worgarside/CubeSolver/Dissertation/Title.tex

\begin{titlepage}
	{\setstretch{1.5}
		
	    \centering
	   	\topskip0pt
	   	\vspace*{\fill}
	   	
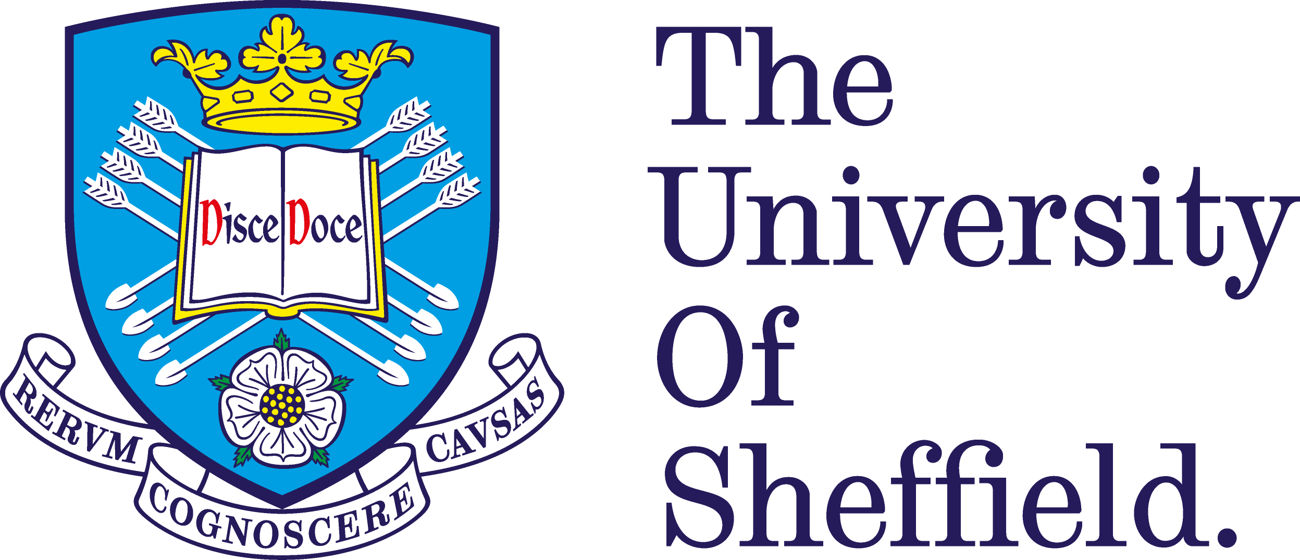
[picture p1: Dissertation/Resources/Images/imgTUoSLogo.png]
		 \\
	   	\vspace{1.5cm}
	    {\Huge Analysis of Rubik's Cube Solution Algorithms with a LEGO Mindstorms Robot} 
	    
		\vspace{1.5cm}
	    
	    {\huge Will Garside}
	    \vspace{2cm}
	    
	    {\Large Supervisor: Dr. Siobh\'{a}n North} \\
	    {\Large Department of Computer Science} \\
	    {\Large COM3610} \\
	    {\Large 2nd May 2018} 
	    
	    \vspace{0.8cm}
	    
		{\Large This report is submitted in partial fulfilment of the requirement for the degree of BSc Computer Science} \\
		{\Large \tit{by}} \\
		{\Large William O. R. Garside} \\
	
	    \vspace*{\fill}
	}
\end{titlepage}
