worgarside/CubeSolver/Dissertation/Research/Thistlethwaite letter.docx

26 Queens Road,

Loughton,

Essex.

13 July 1981.

Dear

Thank you for your letter asking for a copy of my

52-move strategy for solving Rubik's Cube. Please find

enclosed the following:-

(i) General instructions and description (3 pages);

(ii) Tables for Stage 2 (computer print-out);

(iii) Instructions and table for the first part of Stage 3;

(iv) Tables for the latter part of stage 3 (7 typewritten pages);

(v) Tables for Stage 4 (7 pages of computer print-out, photocopied).

I should perhaps point out that this strategy isn't

easy to perform (even John Conway finds it quite hard!),

for two reasons: first, only one representative of each

symmetry class is given in the tables; second, I have

given only the barest documentation. I hope that a fuller

description will be forthcoming at some stage.

On reading the bottom of page 2 of the General Instructions,

you will note that in fact Stage 2 requires two sets of

tables. I have omitted to send you the second of these,

because they are bulky, and only save one move! I hope you

will excuse this liberty. One can always get FU,FD,BU,BD

into the UD-slice (the middle horizontal slice) in at

most five moves in G1.

As an example of the strategy at work, consider the

position where the four upper corners are twisted clockwise,

the four lower corners are twisted antlclockwise, and all

twelve edges are flipped. Then the cube is restored by:-

Stage 1 DBFUR'L'D

Stage 2 L²F²D²F | L²R²F'R'BR²B'R'B'

Stage 3 L²B² | U²LU²F²L²F²L'B²LB²L'

Stage 4 R²U² | R²D²F²U²B²D²F²B²L²B²L²B²

Yours sincerely,

Morwen B. Thistlethwaite.

THE 45-52 MOVE STRATEGY

Introduction. Let G= <L,R,F,B,U,D> , G1= <L,R,F,B,U²,D²> ,

G2= <L,R,F²,B²,U²,D²> , G3= <L2,R2,F2,B2,U²,D²> . The plan is to

manoeuvre down through the chain G=G0> G1> G2> G3> 1. One gets from

Gi to Gi+1 by using moves in Gi only. In its shortest form this

strategy would be executed with the help of a computer, in which case

I conjecture only 45 moves would be needed, but here I have sacrificed

7 moves in order that there should be no need for a computer. With a

few more pages of tables, the figure 52 could be reduced to an

intermediate figure of, say, 49. I intend to do this shortly!

The indexes of the chain of subgroups are 2048, 1082565, 29400, 663552,

but these figures are considerably reduced by considering symmetries.

The reader may check that these indexes multiply together to give the

order of G. The accompanying tables are broadly classified according to

corner positions, and in detail according to edge positions. The words

listed actually produce the positions under consideration, so the

restoring moves are the inverses of these. In order to be able to use

the tables it is necessary to understand the basic characteristics of the

groups G1, G2, G3, so the necessary facts are presented below.

Getting into G1. This involves edge pieces only, and is easy, for which

reason no tables are given. An edge piece is BAD if in taking it home an odd

number of quarter-turns of U and D faces is needed; otherwise it is GOOD

(note that badness is well-defined). The reader may quickly work out a rule of

thumb for deciding whether a piece is GOOD or BAD. Now quarter-turns of

either U or D faces convert BAD pieces to GOOD and vice versa; other moves

have no effect. Therefore to make all edge pieces GOOD, move groups of them

to U or D face avoiding quarter-turns of U or D, and then cure them by

performing a quarter-turn of U or D. For example, if all twelve are BAD,

DBFUR'L'D will cure them all!

Getting from G1 into G2. What has been achieved so far (although

it doesn't look like it) is the correct orientation of edge pieces! In

the present stage, the same is accomplished for corners, and also the

edge pieces FU, FD, BU, BD are brought into their slice. As is well

known, corners do not in general have a natural orientation, but here,

roughly speaking, we shall line them all up the same way. More precisely,

note that each corner piece has either a L-facet or a R-facet: on

completion of this stage each of these facets will lie on either the L

or the R face. In fact, the same will be true of the eight edge pieces

with L or R facets, in view of the statement above regarding FU, FD, BU, BD.

There are 1082565 cases to consider here, this number being the product of

3^7(total number of corner orientations) , and 12C4 (total number of

arrangements of the set {FU, FD, BU, BD} amongst the twelve edge positions).

Surprisingly, with a certain amount of practice it is possible to get

through this stage in at most 17 moves without tables; the same is most

certainly not true of the next stage although there are only 29400 cases.

However, with a few pages of tables this figure of 17 may be reduced to 13;

with a great deal more computation, it should be possible to reduce it

further to 10. To "prove" that 10 moves were sufficient, one would run

through all 10-move sequences on the computer, and check that 1082565 different

cases resulted. This would take no more than a few hours of computer

time, in view of certain short cuts available by considering symmetries.

Now to business. The twist of a corner is measured by looking at its

L or R facet and observing how this has been rotated in relation to the

adjacent L or R face. Note that quarter-turns of F and B faces alter the

twist of corners, whereas all other moves in the group G1 have no effect.

Now in at most 4 moves in G1 try to obtain a position where ~~either the corners~~

~~on the F face or the corners on the B face have zero twist. Note the twist~~

~~of the corners on the opposite face and also the~~ ~~positiosn~~ ~~of the edge pieces~~

the edge pieces FU, FD, BU, BD are all in the UD-slice. If this is not

possible, get them all in the U-face in at most 4 moves.

~~FU, FB, BU, BD, and~~ ~~t~~Then refer to the appropriate detailed table. The

words listed in these tables need to be inverted, as mentioned earlier.

Getting from G2 into G3. This is the trickiest stage theoretically,

and may be broken down for purposes of clarification into two sub-stages:

first get corners into their natural orbits, and second permute the

corners within their orbits so as to obtain one of the 96 corner permutations

in the squares group (G3), while at the same time sorting out the edge

pieces into their correct slices. The table of initial moves on the first

page of Stage 3 tables does part of the first of these substages, and the

detailed tables do the rest. After performing the initial moves, the set

of corners out of orbit will be one of three possibilities (modulo symmetries):

(i) the empty set; (ii) the set {1, 8, 2, 7} ; (iii) the set {1, 5} .

The reader then has to calculate which coset of form G3αβ the permutation

of corners lies in, where α is one of 1, (14)(68), (24)(58), (12), (14), (24),

and β is one of 1, (18)(27), (15). Since some of these cosets are reflections

of others, it was not necessary to produce tables for all six possible values

of α. The task of reflecting positions if necessary is left to the reader.

I apologise for the slightly anomalous numbering of edge positions for this

stage; this was due originally to a typing error in a programs and has

stuck ever since!

Getting from G3 to home. In this final stage one uses only 180 turns.

The order of G3 is 96x6912 = 663552. The tables for this stage give words

for producing each of the 6912 edge positions with corners fixed. Therefore

one must first restore the corners (in at most 4 moves), and then use the

tables to restore the edges. Considerable practice is needed to use these

tables efficiently, but I have found (after considerable practice) that I

can find the desired move in about 2 minutes. One hint is that when faced

with three 3-cycles, consider the configuration of the fixed pieces. Also

it pays to get to know the different sorts of 4-cycle.

STAGE 2 TABLES

FIRST BATCH OF NUMBERS: THE MOVES.

11=L 12=L² 13=L'

21=F 22=F² 23=F'

31=R 32=R² 33=R'

41=B 42=B² 43=B'

51=U² 52=D²

SECOND BATCH OF NUMBERS: TWISTS OF CORNERS.

1=CLOCKWISE 2=ANTICLOCKWISE 0=NO EFFECT

FINAL NUMBER: NUMBER OF SYMMETRICALLY EQUIVALENT POSITIONS.

N.B. FOR INITIAL 1X READ 21 1X.

21 11 31 22 11 31 51 52 21 0 0 0 0 0 0 0 0 1

21 11 33 42 11 51 33 52 21 0 0 0 1 0 0 2 0 4

21 11 22 51 52 12 22 33 21 0 0 0 1 1 0 2 2 8

21 11 22 31 43 51 13 22 11 0 0 0 1 1 1 2 1 8

21 11 52 11 21 31 52 41 51 0 0 0 1 2 2 0 1 8

21 11 22 12 52 12 52 31 41 0 0 0 2 0 1 2 1 8

11 21 33 23 11 32 51 52 23 0 0 1 0 0 0 2 0 4

11 21 33 23 11 32 51 52 21 0 0 1 0 2 0 0 0 4

11 42 31 21 13 42 33 41 51 0 0 1 1 0 0 2 2 2

21 11 21 33 42 11 23 12 43 0 0 1 1 0 1 0 0 8

21 11 22 31 41 11 32 42 13 0 0 1 1 1 0 1 2 8

21 11 31 21 51 31 21 41 11 0 0 1 1 2 2 0 0 2

21 11 22 32 41 51 13 22 11 0 0 1 1 2 2 2 1 8

21 11 21 41 11 23 41 11 43 0 0 1 2 0 0 0 0 8

21 11 41 51 41 12 42 11 41 0 0 1 2 0 0 1 2 4

21 11 42 12 41 52 41 11 41 0 0 1 2 0 0 2 1 4

21 11 21 32 42 11 23 12 43 0 0 1 2 0 1 0 2 8

21 11 22 12 22 51 31 52 21 0 0 1 2 1 0 0 2 8

21 11 21 12 23 42 11 43 12 0 0 1 2 1 0 1 1 8

21 11 22 13 21 31 21 11 41 0 0 1 2 1 1 0 1 8

21 11 21 41 11 23 43 11 43 0 0 1 2 2 1 0 0 4

21 11 22 11 52 33 51 21 51 0 0 2 0 0 0 0 1 4

21 11 22 11 22 52 33 51 23 0 0 2 0 0 0 1 0 4

21 11 22 11 52 33 51 21 12 0 0 2 0 0 1 0 0 4

21 11 22 11 22 52 33 51 21 0 0 2 0 1 0 0 0 4

21 11 33 42 11 21 12 31 43 0 0 2 1 1 0 0 2 8

21 11 22 13 21 13 21 12 43 0 0 2 1 1 1 2 2 8

21 11 21 11 52 11 23 11 43 0 0 2 2 0 0 1 1 2

21 11 22 11 32 52 33 51 23 0 0 2 2 0 0 2 0 8

21 11 23 11 33 51 21 12 43 0 0 2 2 2 0 0 0 8

21 11 51 31 23 52 12 21 33 0 1 0 0 0 2 1 2 8

21 11 22 51 52 12 22 33 23 0 1 0 0 2 0 1 2 8

21 11 52 11 21 31 52 41 12 0 1 0 0 2 1 0 2 8

21 11 32 43 12 31 43 51 31 0 1 0 0 2 2 2 2 8

21 11 21 43 11 31 21 51 31 0 1 0 1 2 0 1 1 8

21 12 22 51 52 31 22 32 21 0 1 0 1 2 0 2 0 2

11 23 41 31 41 11 33 52 21 0 1 0 1 2 2 0 0 8

21 11 22 12 51 31 52 21 12 0 1 0 2 0 0 1 2 8

21 11 32 51 43 52 33 23 12 0 1 0 2 0 2 0 1 4

11 22 11 51 41 11 52 23 51 0 1 0 2 1 0 2 0 4

21 11 42 51 41 11 33 23 33 0 1 0 2 2 1 2 1 8

21 11 51 33 41 33 21 51 11 0 1 0 2 2 2 0 2 8

11 22 51 43 11 33 21 42 11 0 1 1 0 0 2 0 2 8

12 22 51 52 31 22 32 21 31 0 1 1 0 2 0 0 2 2

21 11 21 43 11 31 21 51 33 0 1 1 0 2 0 1 1 8

21 11 22 31 41 13 22 13 22 0 1 1 0 2 1 0 1 8

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

21 11 21 11 22 33 21 12 41 2 2 2 2 0 2 1 1 8

21 11 21 13 23 31 21 33 43 2 2 2 2 0 2 2 0 4

21 11 21 31 42 33 23 13 41 2 2 2 2 1 1 1 1 1

21 11 22 32 51 11 52 33 21 2 2 2 2 2 0 2 0 4

21 11 21 31 21 33 22 13 41 2 2 2 2 2 2 1 2 8

STAGE 3: GETTING INTO THE SQUARES GROUP

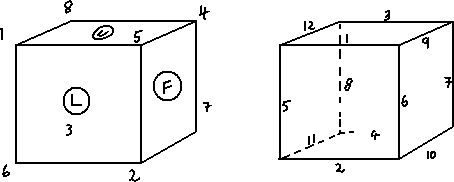
[picture p55: figure]

Corners and edges are numbered as in the above diagrams.

Moves are coded as follows:

1=L, 2=L², 3=L', 4=F², 5=R, 6=R², 7=R', 8=B², 9=U², 10=D².

To accomplish stage 3, proceed as follows:

(i) Establish which corners are out of orbit.

(ii) Perform moves as indicated in the table below.

(iii) Find by calculation the right coset of the squares group

in which the permutation of corners now lies.

(iv) Refer to the appropriate detailed table. Find the numbers

of the positions of the four edge pieces of the FB-slice,

i.e. LU, LD, RU, RD. Find the number in the left-hand

column corresponding to these, and perform the inverse of

the given move. since some cosets are reflections of

others, the reader may have to undertake the extra task

of reflecting his position to find a suitable table.

CORNERS OUT OF ORBIT | INITIAL MOVE

1,5 | -

1,6 | -

1,7 | 4

1,8 | 2 9

1,2,5,6 | 1

1,2,5,7 | 1 4

1,2,5,8 | 3 9

1,2,7,8 | -

1,3,6,8 | 9

1,3,5,7 | 6 4

1,3,5,8 | 1 9

1,2,3.5,6,7 | 1

1,2,3,5,7,8 | 4 5

1,2,3,6,7,8 | 1 5 9

1,2,3,4,5,6,7,8 | 1 5

CORNERS OUT OF ORBIT: NONE COSET: G COSET: G(14)(68)

1234 - 1 4 1 4 1 5 8 1 8 7

1235 1 4 1 7 4 10 2 7 1 4 1 4 9 2 9 7 4 7

1236 1 4 1 7 4 10 7 8 1 4 1 4 2 9 1 8 10 7

1237 1 4 1 7 4 10 7 4 1 4 1 4 2 8 9 7 9 7

1238 1 4 1 7 4 9 3 10 1 4 3 4 2 8 10 1 8 3

1245 1 4 1 7 4 10 2 5 1 4 1 4 2 9 1 4 10 7

1246 1 4 1 7 4 10 5 8 1 4 1 4 9 2 9 3 9 3

1247 1 4 1 7 4 10 5 4 1 4 3 4 1 5 8 3 8 10 3

1248 1 4 1 7 4 9 1 9 1 4 1 4 2 8 9 3 8 3

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

Now taking the corner positions in order (as in the

diagram in Stage 3 instructions), the respective twists of

the pieces in these positions are 0,2,0,2,0,0,1,1. This

combination of twists is not given in Stage 2 tables, but

a 180° rotation about the LR-axis followed by reflection

in the LR-slice transforms this to 2 2 0 0 0 1 0 1, which

is in the tables. The move given is F LFL2F'LF²BL², and

transforming this by the above (involutory) symmetry gives

B'R'B'R²BR'B²F'R². Therefore we perform the inverse of

this move, after which L and R faces have L and R colours

on them only.

Summary of Stage 2:- F²D²LR'FR²FB²RB'R²BRB (14 moves)

Stage 3. The positions where corners are out of orbit are

numbers 1,2,5,8. The preliminary instructions for this

stage instruct us to perform L'U². For the remainder of

this stage alter the coordinate system so that the original

D-face faces you and the original F-face faces upwards.

In this new coordinate system the positions where corners

are out of orbit are 1,5. The permutation of corners is

(1357)(24). Multiplying this on the right by (15)(24) gives

(13)(57) which is a permutation of corners in G3. Therefore

we must refer to page 7 of the Stage 3 tables. The edge-

pieces of the FB-slice are in positions 3,4,5,8. The tables

give us LF²L'U²LF²R²F²B²R, or LD²L'F²LD²R²D²U²R in the

original coordinate system. Perform the inverse of this move.

Summary of Stage 3:- L'U²R'U²D²R²D²L'F²LD²L' (12 moves).

Stage 4. The corners are restored by L²R²(original coordinates).

Looking at edge-pieces, as no slice is fixed and there is

a 2-cycle and a 4-cycle, we refer to page 7 of the Stage 4

tables. The only entries where the correct arrangement of

pieces is permuted and the 4-cycle is of the correct type are

(143) (1342) (34) and (143) (1243) (34). If we hold the

Cube with the original R-face facing the operator, and the

original B-face uppermost, we find we have the second of these

permutations. Therefore perform the inverse of the move

given, i.e. perform B²R²F²R²D²U²B²U²R²U²R²U²in original coords.

Summary of Stage 4:- L²R²B²R²F²R²D²U²B²U²R²U²R²U²(14 moves).

Total number of moves required: 6+14+12+14 = 46. (45 with cancellation)

M.B.T.
