worgarside/CubeSolver/Dissertation/Research/rvgrol@hotmail.com/IMG_0400.JPG.JPG

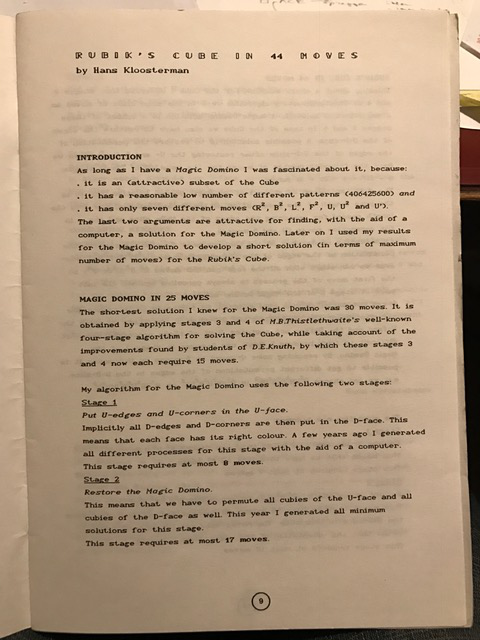
Dissertation/Research/rvgrol@hotmail.com/IMG_0400.JPG.JPG
