worgarside/CubeSolver/Dissertation/Research/rvgrol@hotmail.com/IMG_0401.JPG.JPG

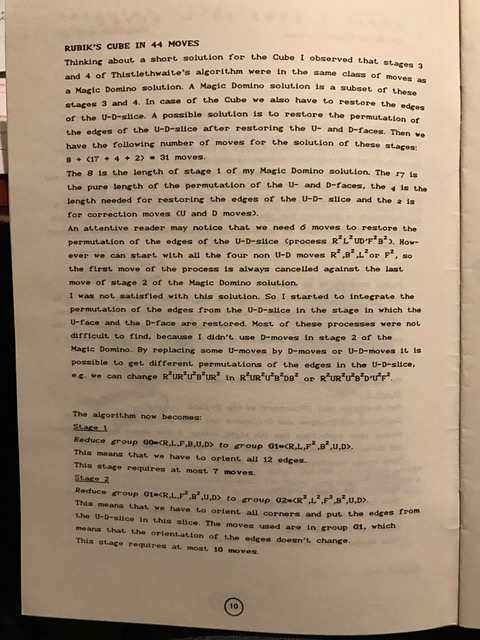
Dissertation/Research/rvgrol@hotmail.com/IMG_0401.JPG.JPG
