worgarside/CubeSolver/Dissertation/Research/rvgrol@hotmail.com/IMG_0402.JPG.JPG

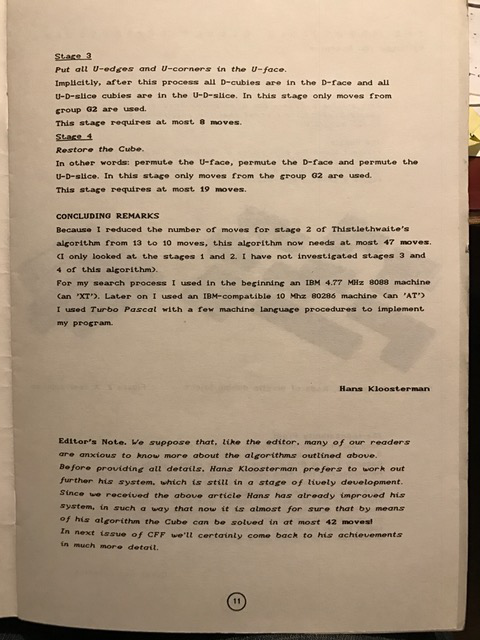
Dissertation/Research/rvgrol@hotmail.com/IMG_0402.JPG.JPG
