worgarside/CubeSolver/Dissertation/Resources/Images/dwgCubeProfile.PNG

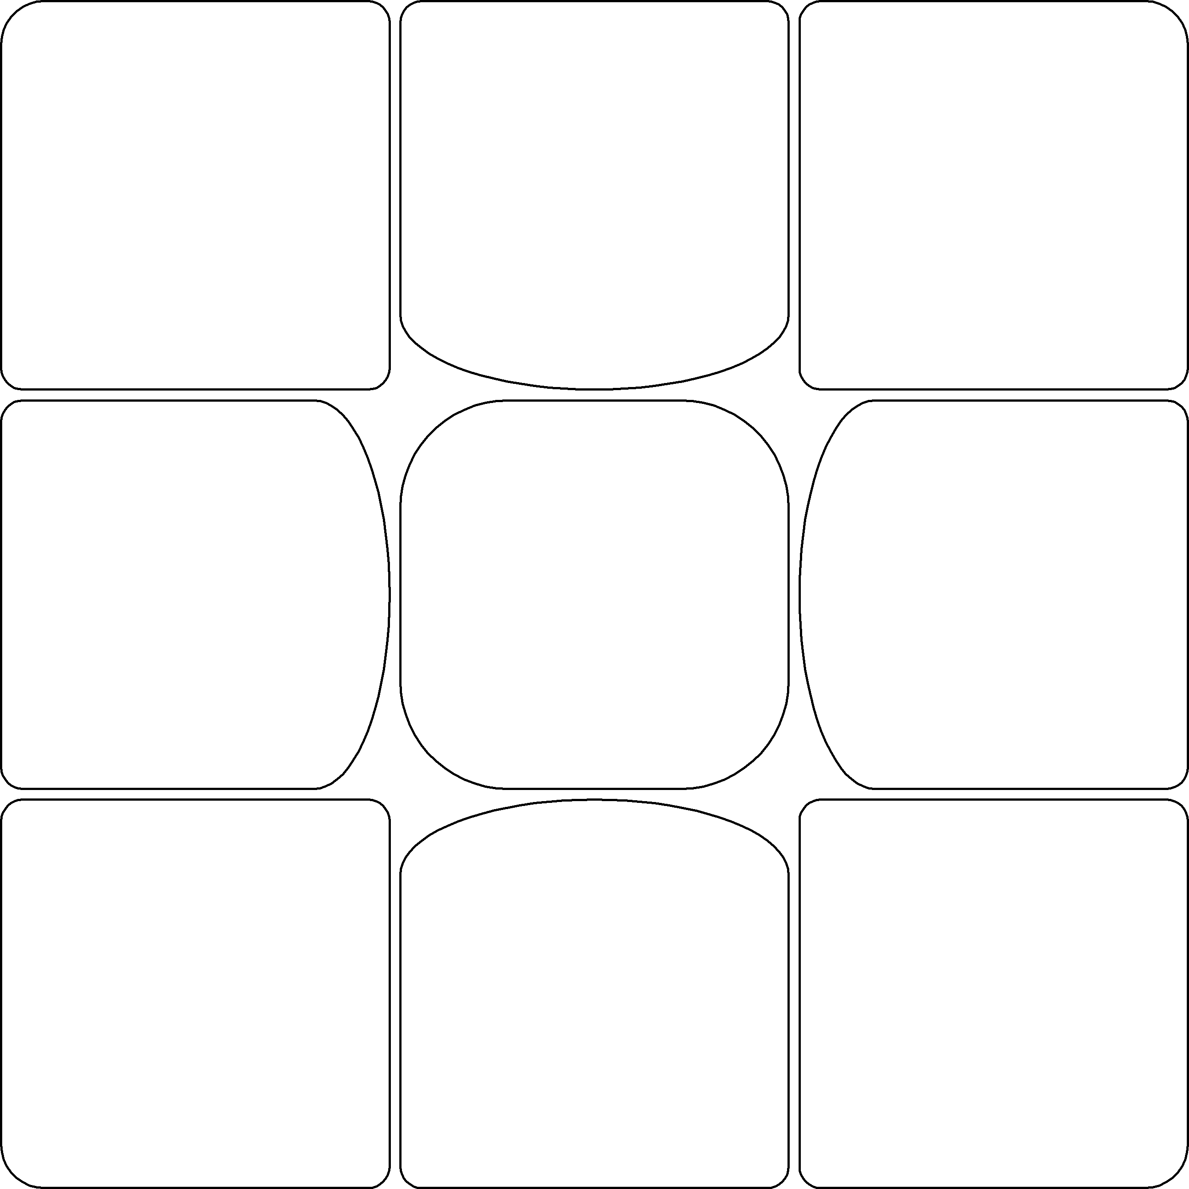
Dissertation/Resources/Images/dwgCubeProfile.PNG
