worgarside/CubeSolver/Dissertation/Resources/Images/imgBatteryHolder.jpg

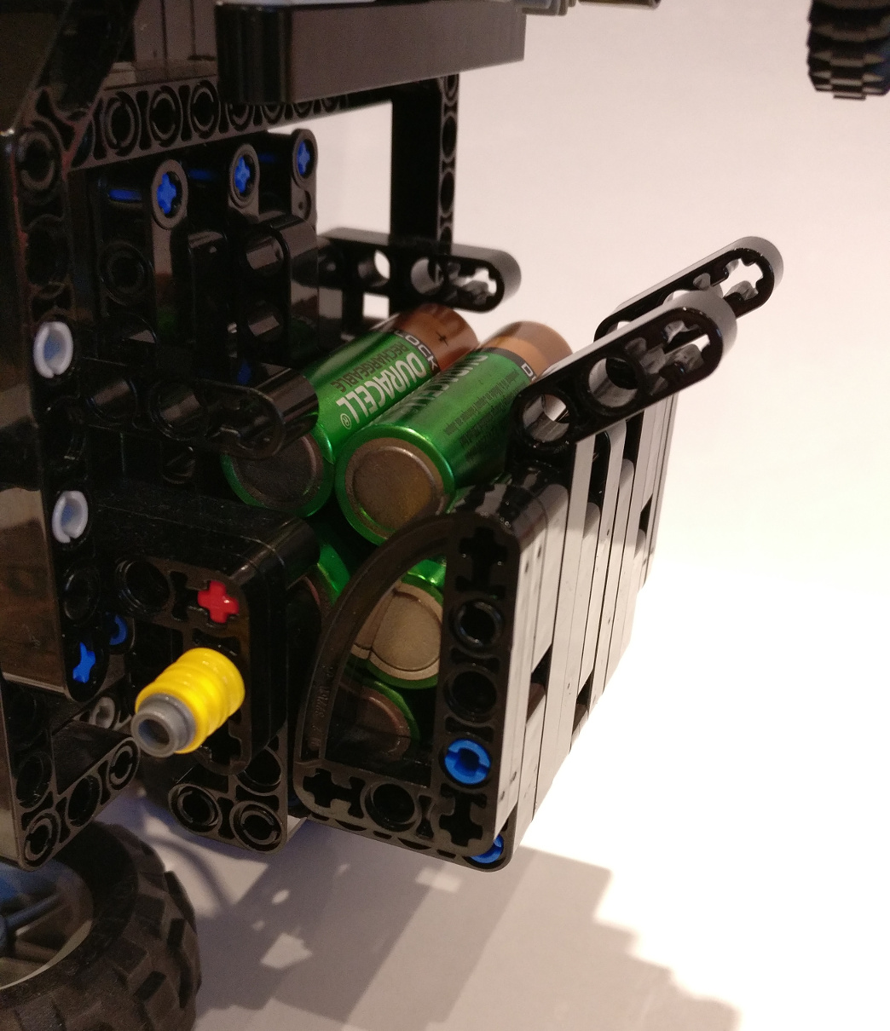
Dissertation/Resources/Images/imgBatteryHolder.jpg
