worgarside/CubeSolver/Dissertation/Resources/Images/imgBatteryHolderOpen.jpg

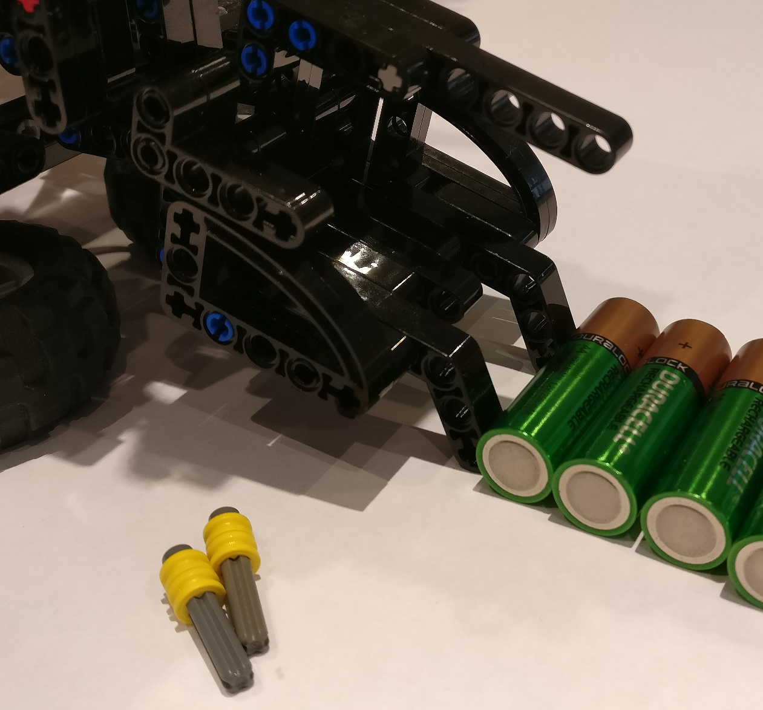
Dissertation/Resources/Images/imgBatteryHolderOpen.jpg
