worgarside/CubeSolver/Dissertation/Resources/Images/rdrBatteryHolder.png

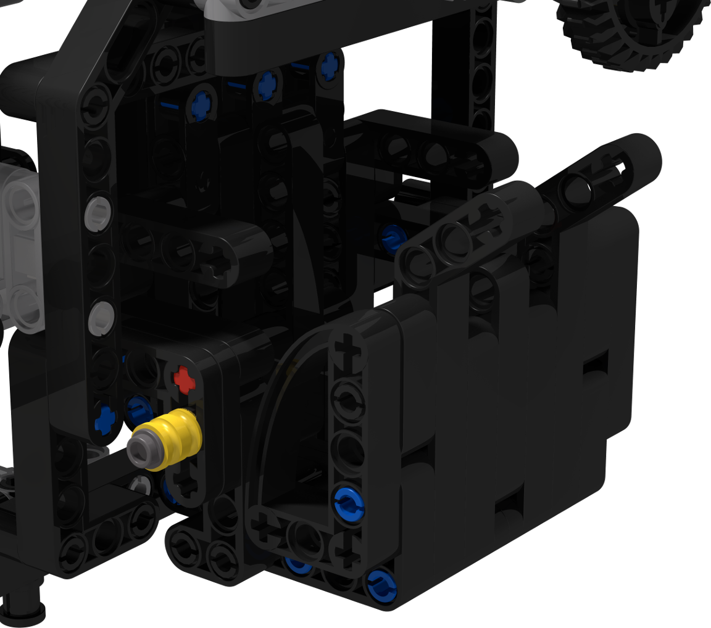
Dissertation/Resources/Images/rdrBatteryHolder.png
