worgarside/CubeSolver/Dissertation/Resources/Images/rdrFullRobotV1Rear.png

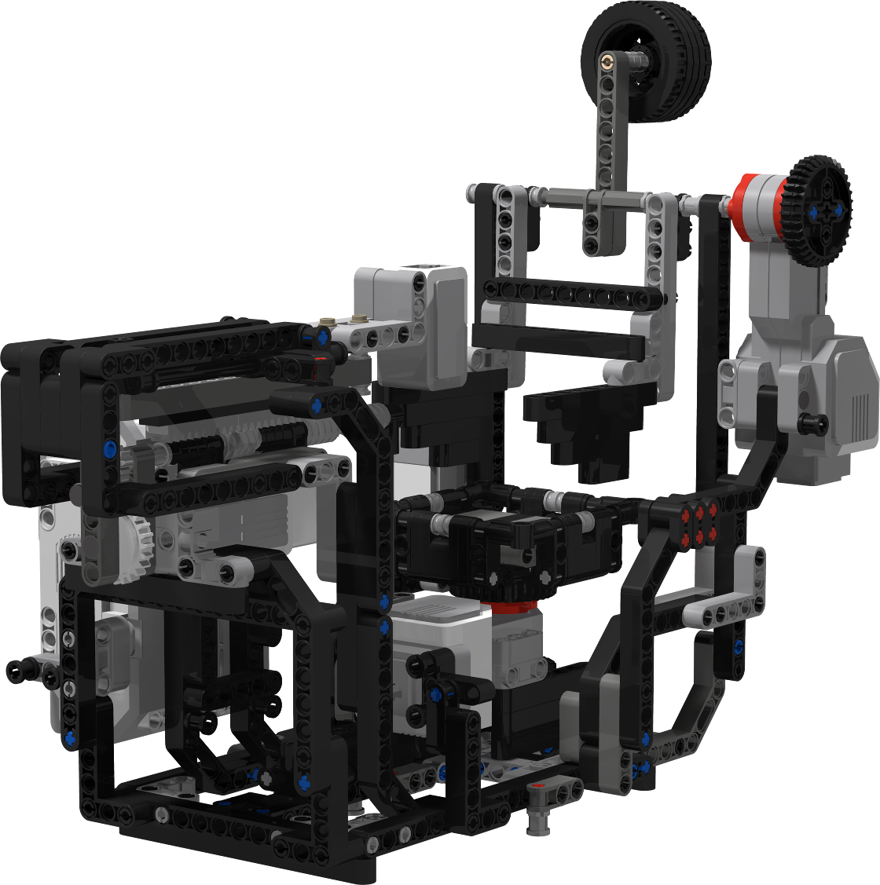
Dissertation/Resources/Images/rdrFullRobotV1Rear.png
