worgarside/CubeSolver/Dissertation/Resources/Images/rdrLego60c01.png

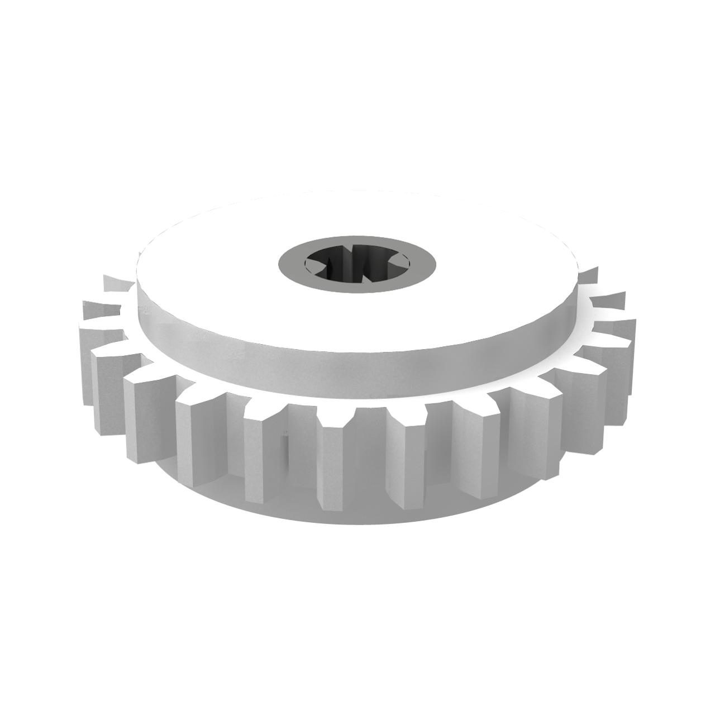
Dissertation/Resources/Images/rdrLego60c01.png
