worgarside/CubeSolver/Dissertation/Resources/Images/rdrLego3647.png

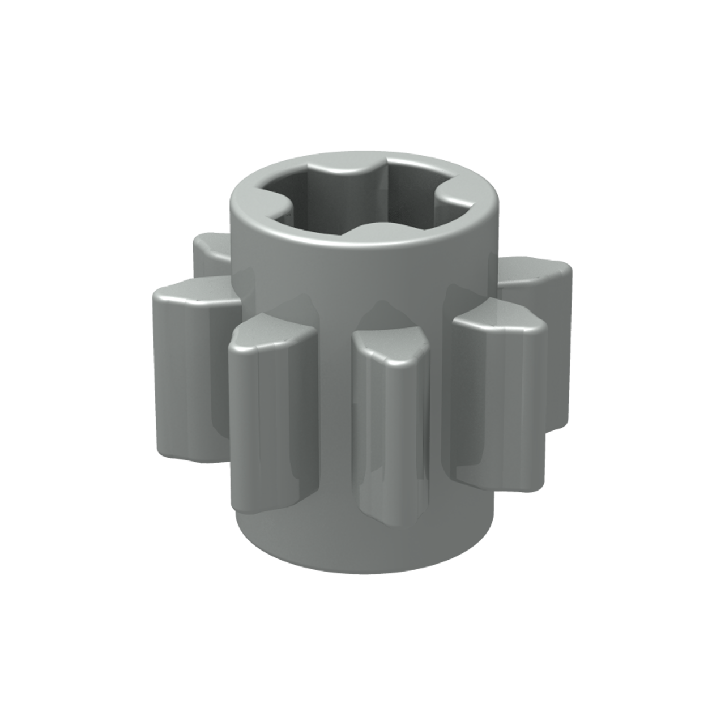
Dissertation/Resources/Images/rdrLego3647.png
