worgarside/CubeSolver/Dissertation/Resources/Images/rdrLego3649.png

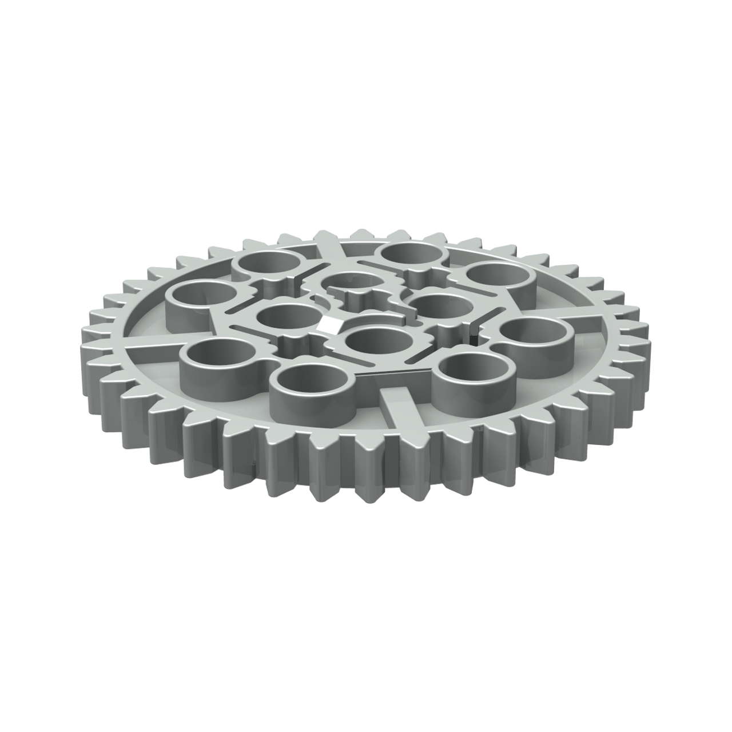
Dissertation/Resources/Images/rdrLego3649.png
