worgarside/CubeSolver/Dissertation/Resources/Images/rdrLego3708.png

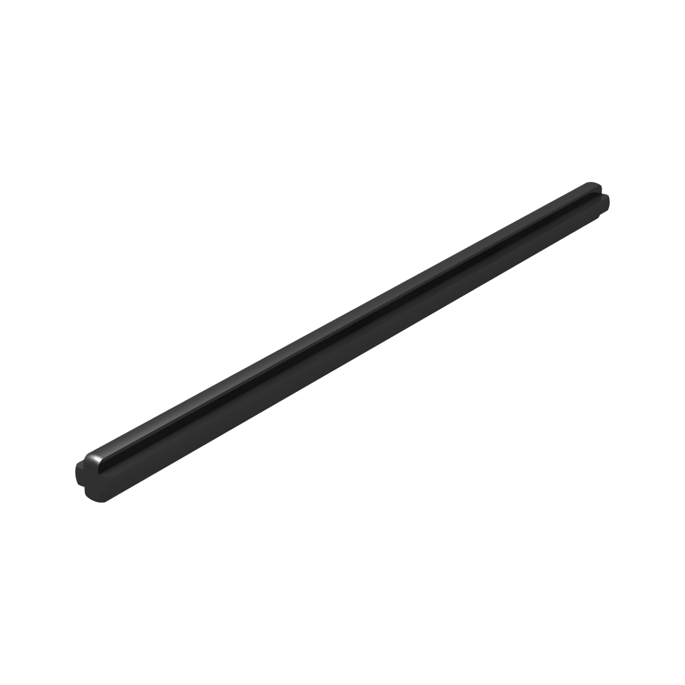
Dissertation/Resources/Images/rdrLego3708.png
