worgarside/CubeSolver/Dissertation/Resources/Images/rdrLego3743.png

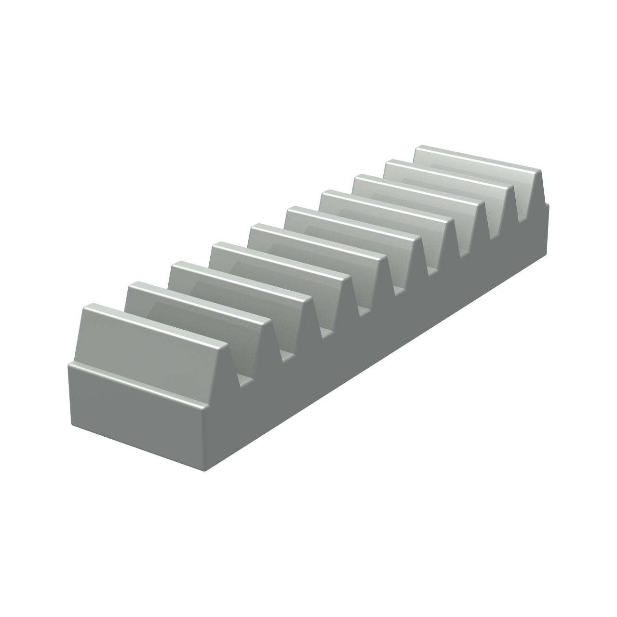
Dissertation/Resources/Images/rdrLego3743.png
