worgarside/CubeSolver/Dissertation/Resources/Images/rdrLego4716.png

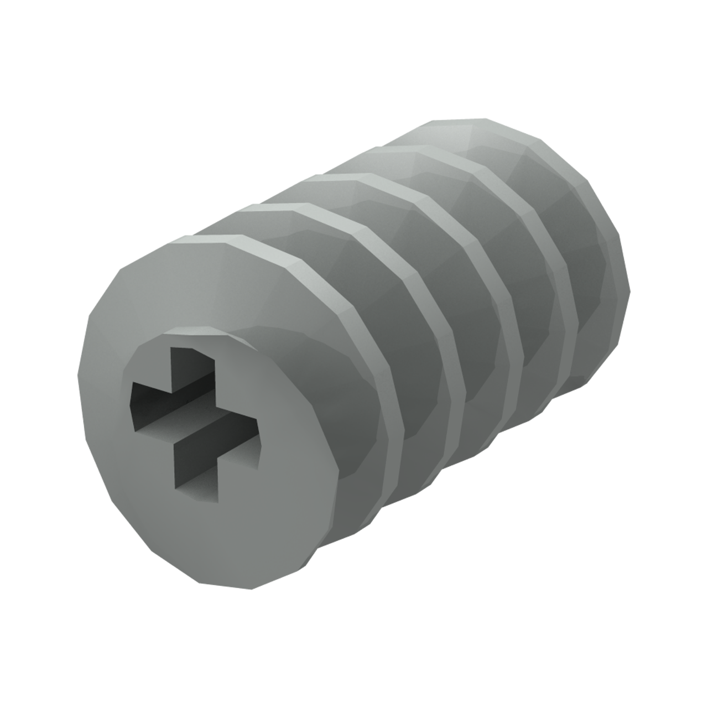
Dissertation/Resources/Images/rdrLego4716.png
