worgarside/CubeSolver/Dissertation/Resources/Images/rdrLego32009.png

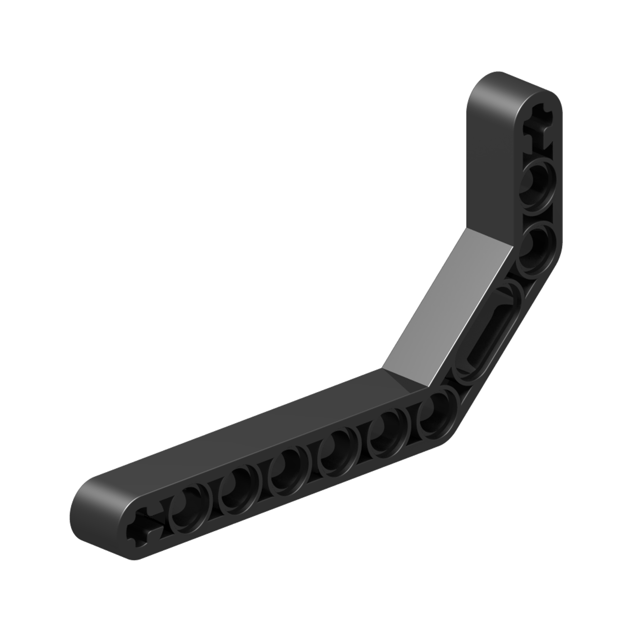
Dissertation/Resources/Images/rdrLego32009.png
