worgarside/CubeSolver/Dissertation/Resources/Images/rdrLego32054.png

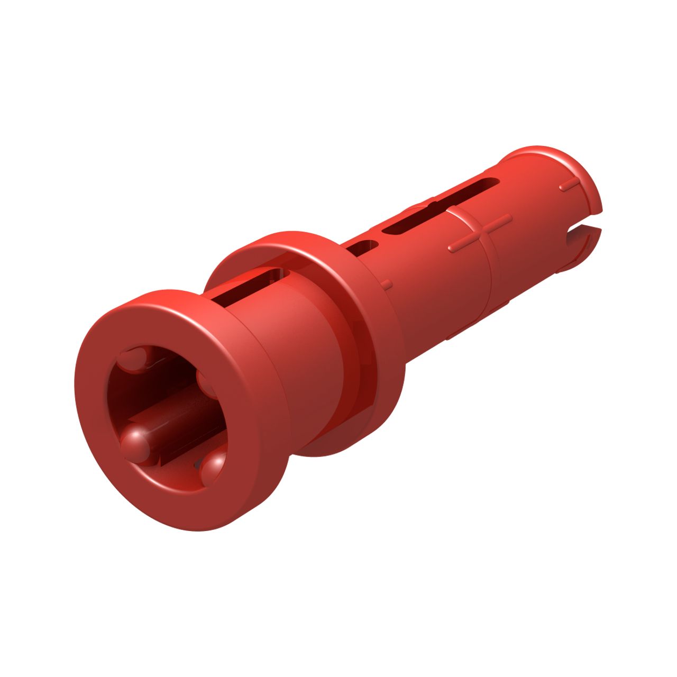
Dissertation/Resources/Images/rdrLego32054.png
