worgarside/CubeSolver/Dissertation/Resources/Images/rdrLego32062.png

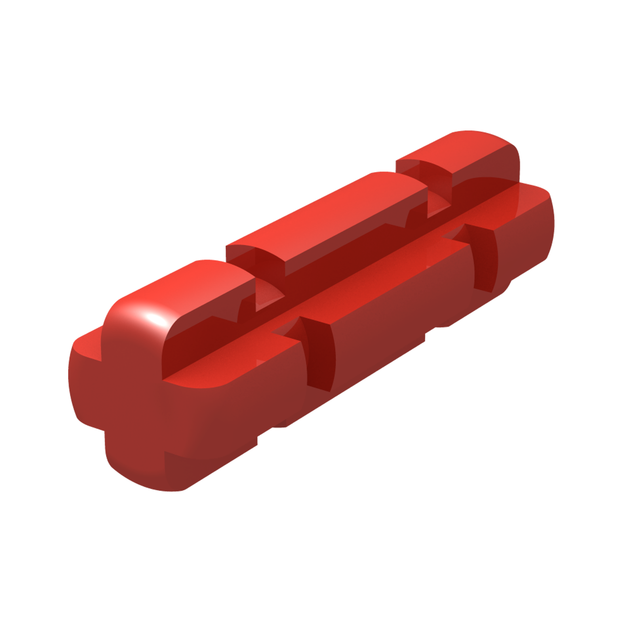
Dissertation/Resources/Images/rdrLego32062.png
