worgarside/CubeSolver/Dissertation/Resources/Images/rdrLego32270.png

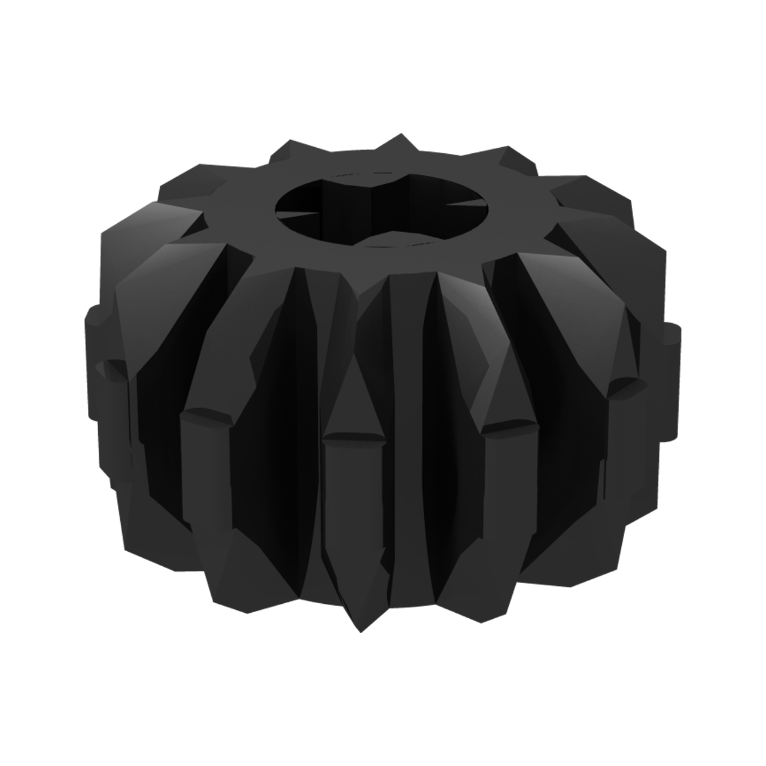
Dissertation/Resources/Images/rdrLego32270.png
