worgarside/CubeSolver/Dissertation/Resources/Images/rdrLego32498.png

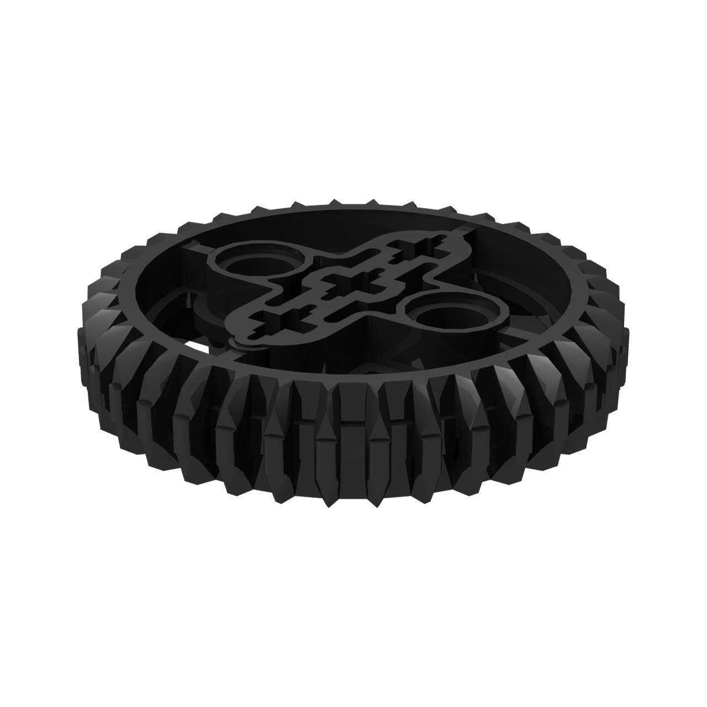
Dissertation/Resources/Images/rdrLego32498.png
