worgarside/CubeSolver/Dissertation/Resources/Images/rdrLego32526.png

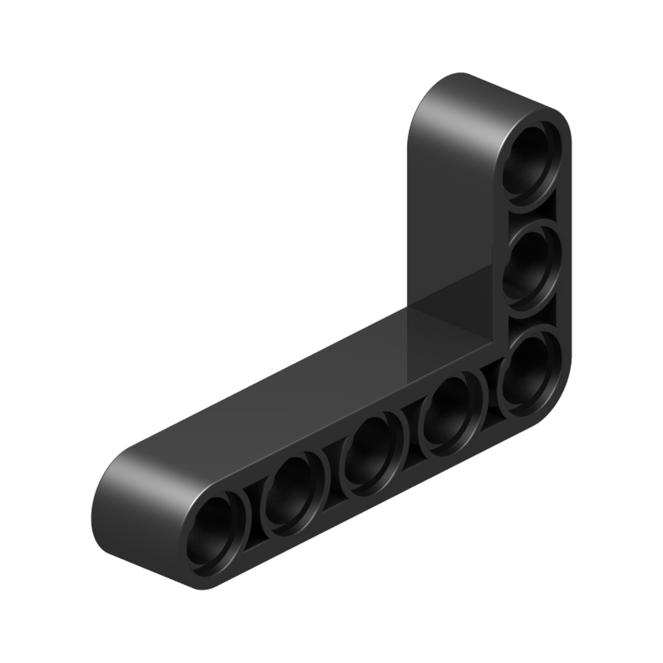
Dissertation/Resources/Images/rdrLego32526.png
