worgarside/CubeSolver/Dissertation/Resources/Images/rdrLego40490.png

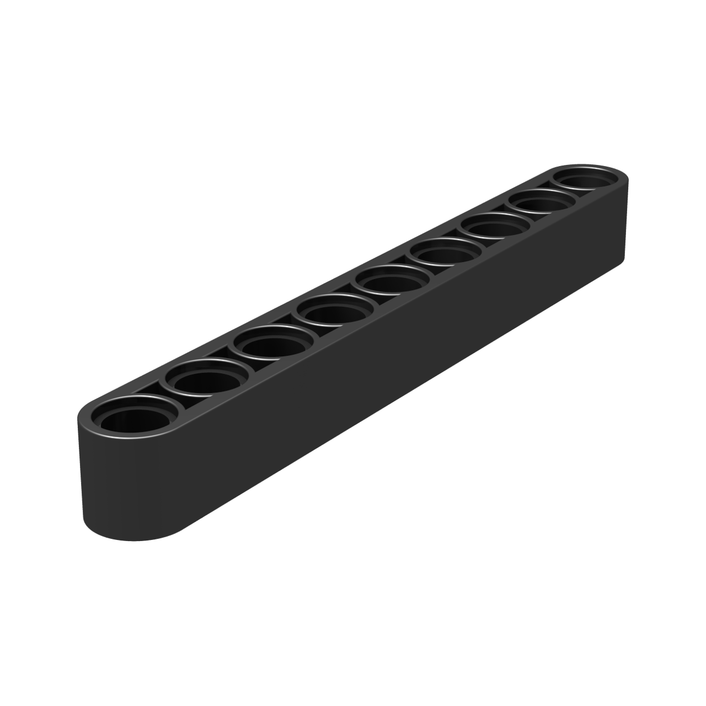
Dissertation/Resources/Images/rdrLego40490.png
