worgarside/CubeSolver/Dissertation/Resources/Images/rdrLego45502.png

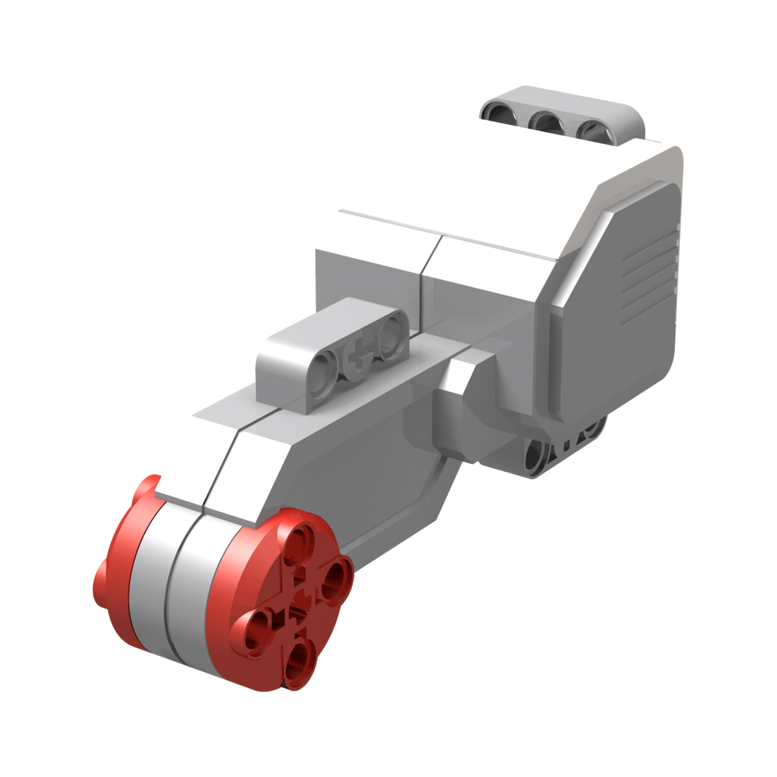
Dissertation/Resources/Images/rdrLego45502.png
