worgarside/CubeSolver/Dissertation/Resources/Images/rdrLego45503.png

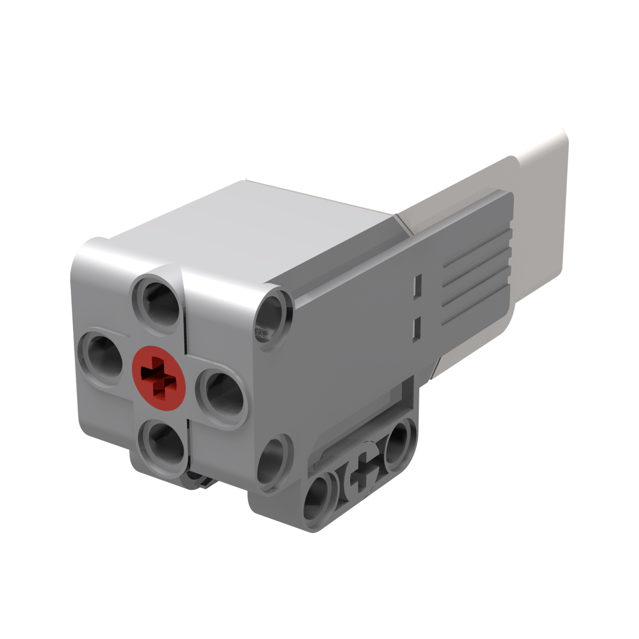
Dissertation/Resources/Images/rdrLego45503.png
