worgarside/CubeSolver/Dissertation/Resources/Images/rdrLego45506.png

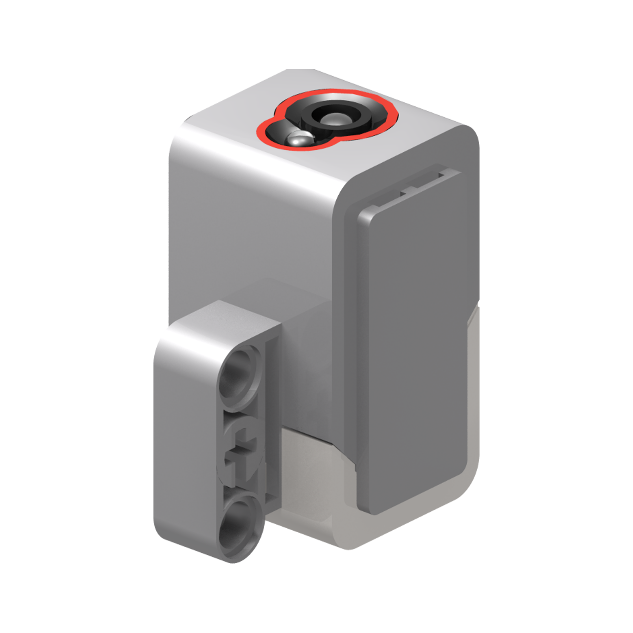
Dissertation/Resources/Images/rdrLego45506.png
