worgarside/CubeSolver/Dissertation/Resources/Images/rdrLego45507.png

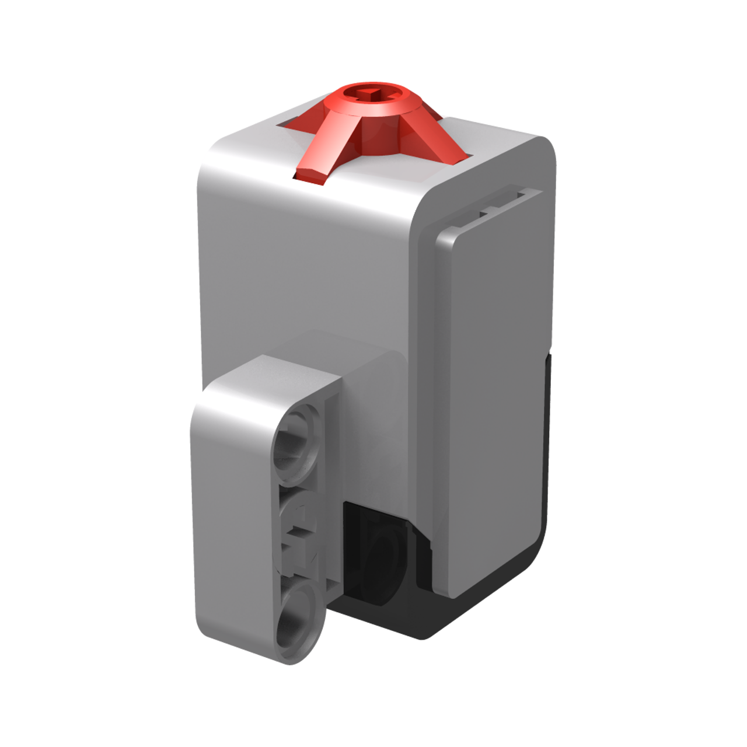
Dissertation/Resources/Images/rdrLego45507.png
