worgarside/CubeSolver/Dissertation/Resources/Images/rdrLego55615.png

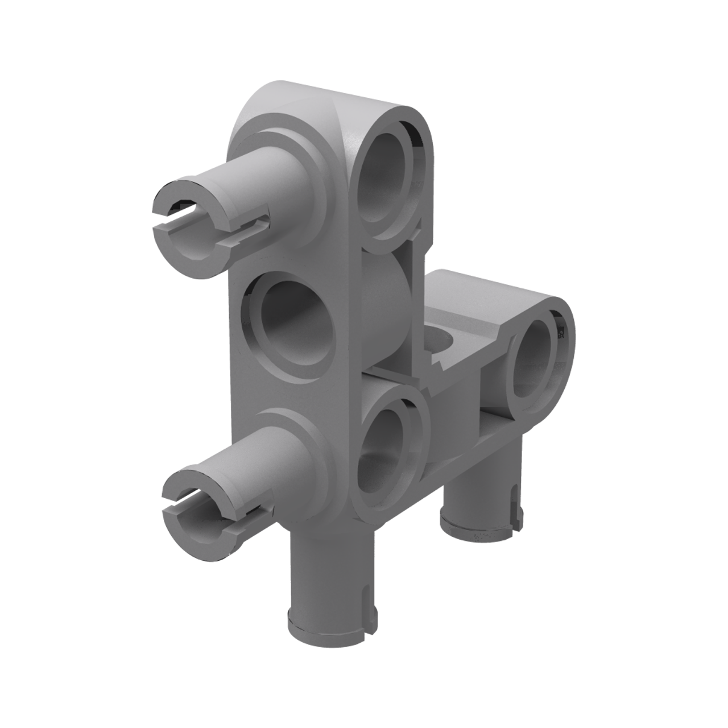
Dissertation/Resources/Images/rdrLego55615.png
