worgarside/CubeSolver/Dissertation/Resources/Stud.io/Robot MkII #7.png

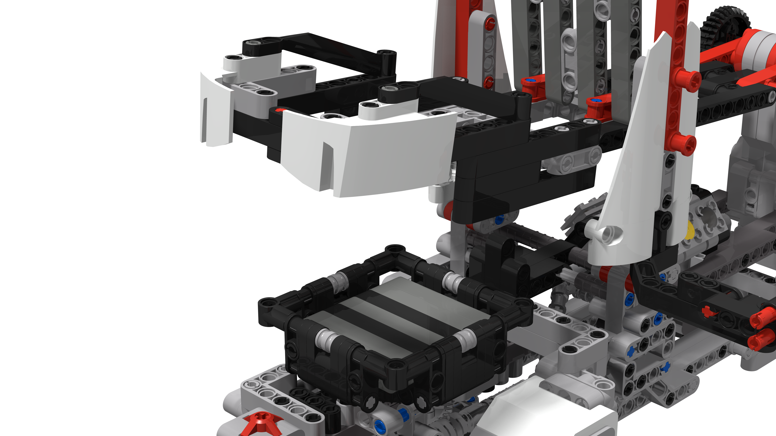
Dissertation/Resources/Stud.io/Robot MkII #7.png
