worgarside/CubeSolver/Dissertation/Resources/SolidWorks/Assemblies/CradleProfileV1.SLDASM

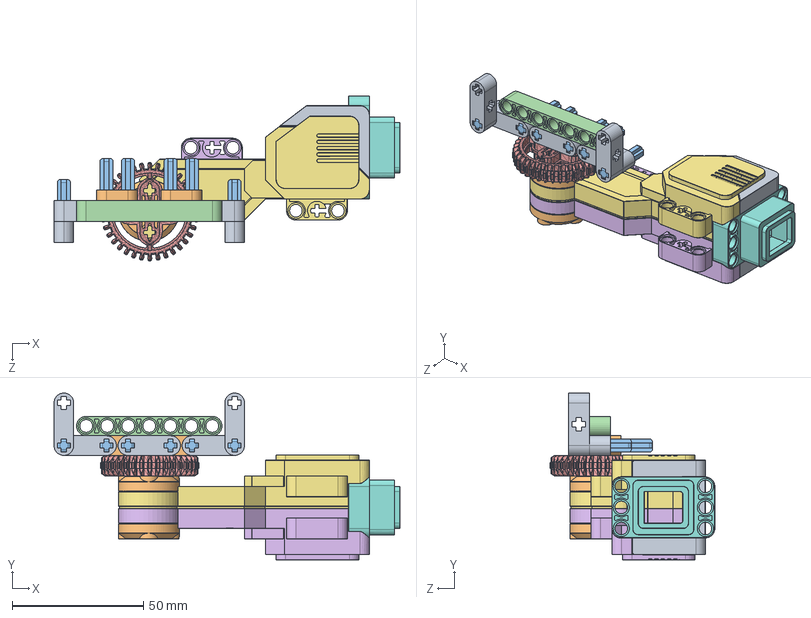
[picture p97: CAD file, 2018-04-01]
Dissertation/Resources/SolidWorks/Assemblies/CradleProfileV1.SLDASM
131.7 x 63.5 x 62.7 mm
Cradle Part 1 x 5
Cradle Part 2 x 2
Axle x 7
Beam
99550-LtBluishGray
99551-LtBluishGray
10825-LtBluishGray
99555-White
99617-Red x 2
