worgarside/CubeSolver/Dissertation/Resources/SolidWorks/Assemblies/Color Sensor.SLDASM

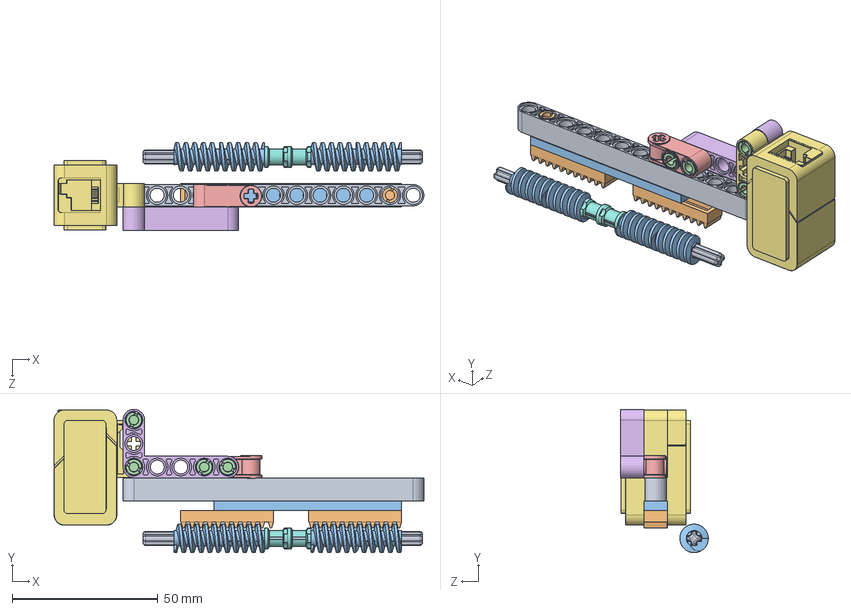
[picture p98: CAD file, 2018-03-05]
Dissertation/Resources/SolidWorks/Assemblies/Color Sensor.SLDASM
127.1 x 49.2 x 30.1 mm
Bush x 2
Worm Gear x 4
