worgarside/CubeSolver/Dissertation/Resources/SolidWorks/Assemblies/CradleProfile Worm Gear.SLDASM

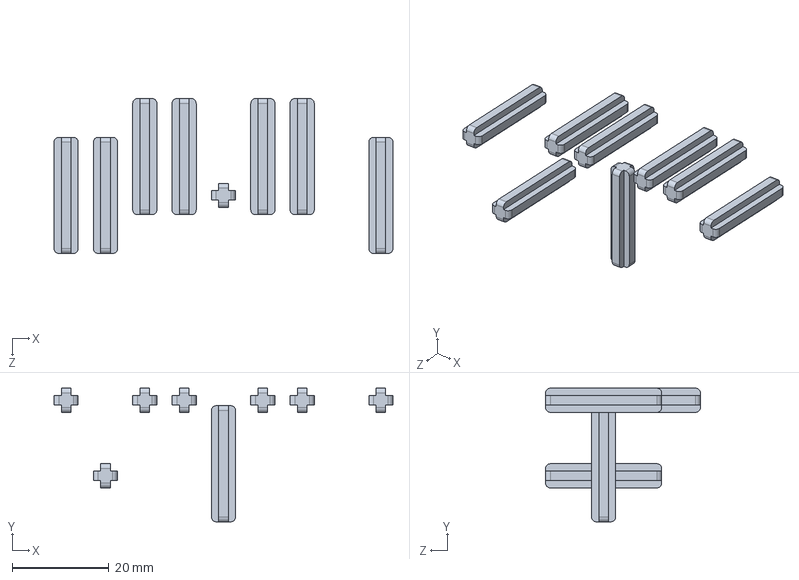
[picture p99: CAD file, 2018-03-05]
Dissertation/Resources/SolidWorks/Assemblies/CradleProfile Worm Gear.SLDASM
70.0 x 27.6 x 32.0 mm
Axle x 8
