worgarside/CubeSolver/Dissertation/Resources/SolidWorks/Assemblies/Swing Arm MkI.SLDASM

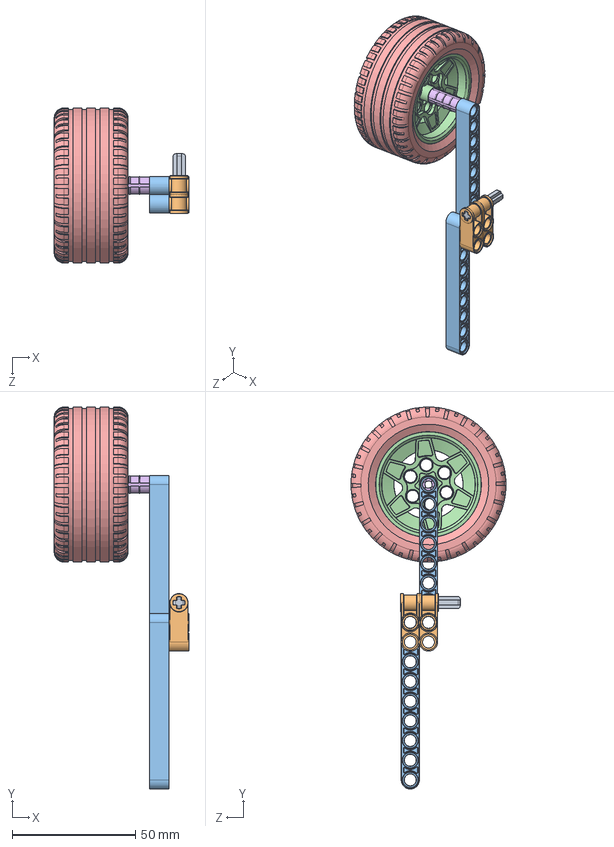
[picture p100: CAD file, 2018-03-03]
Dissertation/Resources/SolidWorks/Assemblies/Swing Arm MkI.SLDASM
54.7 x 155.2 x 63.0 mm
Axle
6538a
