worgarside/CubeSolver/Dissertation/Resources/SolidWorks/Assemblies/Wheel.SLDASM

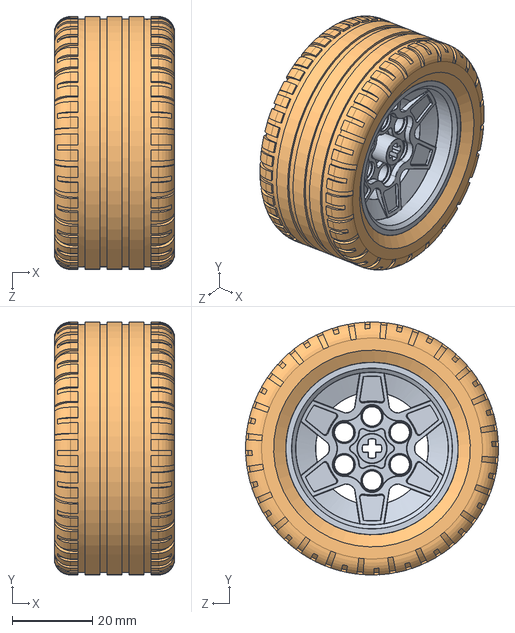
[picture p101: CAD file, 2018-03-03]
Dissertation/Resources/SolidWorks/Assemblies/Wheel.SLDASM
30.0 x 63.0 x 63.0 mm
