worgarside/CubeSolver/Dissertation/Resources/SolidWorks/Assemblies/CradleProfile Straight Edged.SLDASM

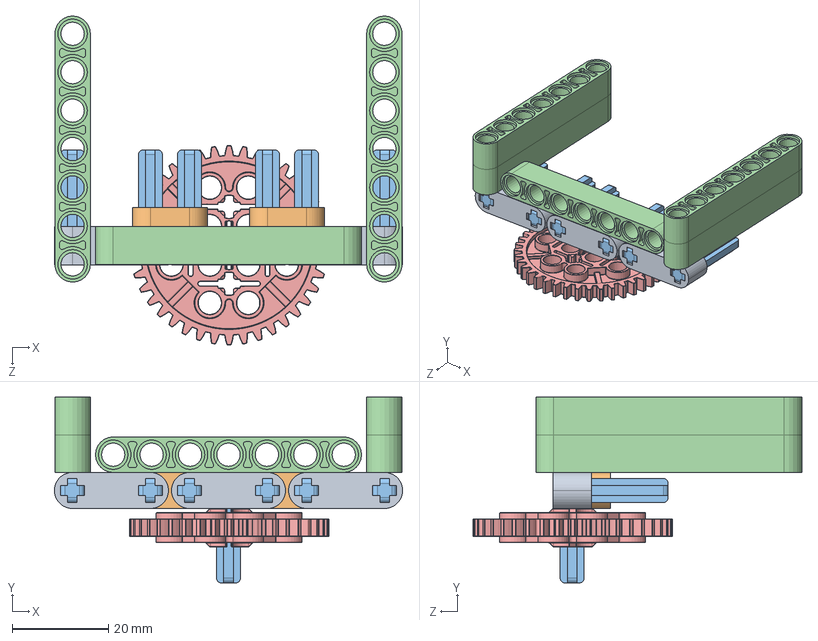
[picture p102: CAD file, 2018-03-01]
Dissertation/Resources/SolidWorks/Assemblies/CradleProfile Straight Edged.SLDASM
72.5 x 38.7 x 68.5 mm
Cradle Part 1 x 3
Cradle Part 2 x 2
Axle x 7
Beam x 5
Gear
