worgarside/CubeSolver/Dissertation/Resources/SolidWorks/SldParts/Bush.SLDPRT

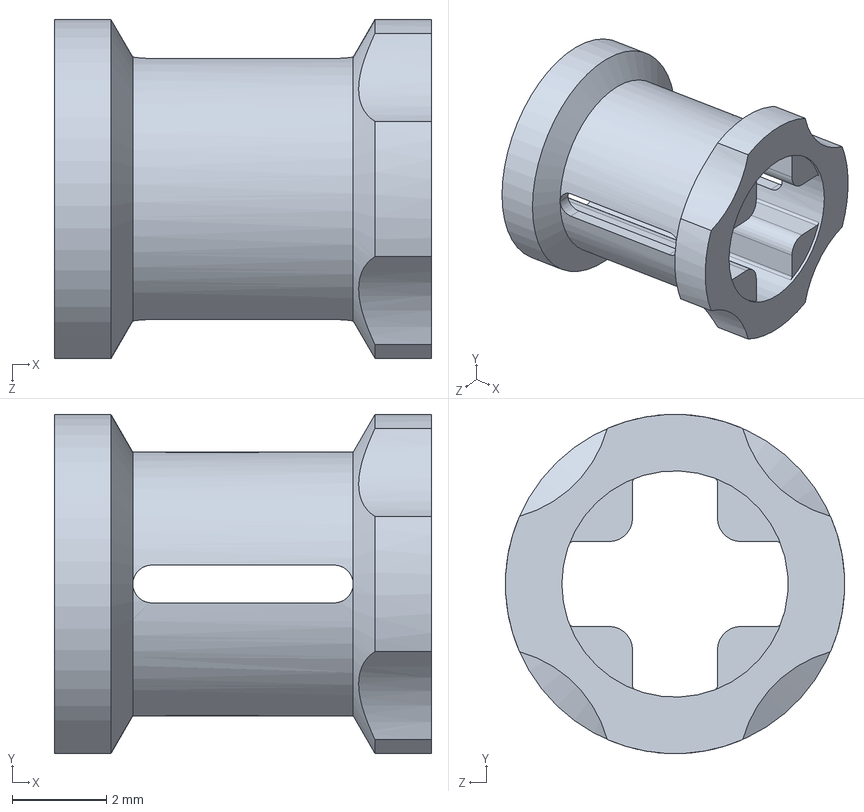
[picture p103: CAD file, 2018-03-05]
Dissertation/Resources/SolidWorks/SldParts/Bush.SLDPRT
8.00 x 7.20 x 7.20 mm
