worgarside/CubeSolver/Dissertation/Resources/SolidWorks/SldParts/3708.SLDPRT

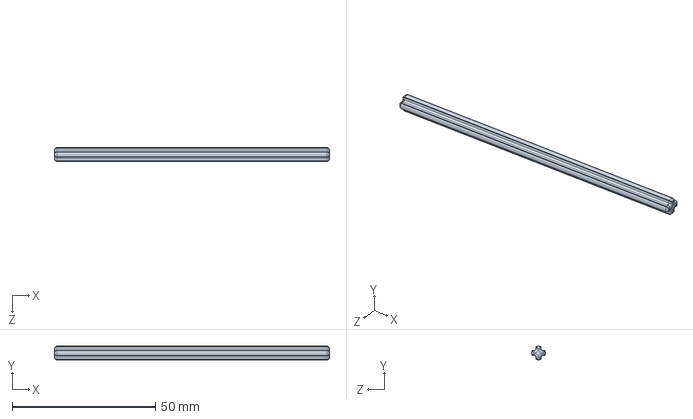
[picture p104: CAD file, 2018-03-05]
Dissertation/Resources/SolidWorks/SldParts/3708.SLDPRT
96.0 x 4.77 x 4.77 mm
