worgarside/CubeSolver/Dissertation/Resources/SolidWorks/SldParts/4162.SLDPRT

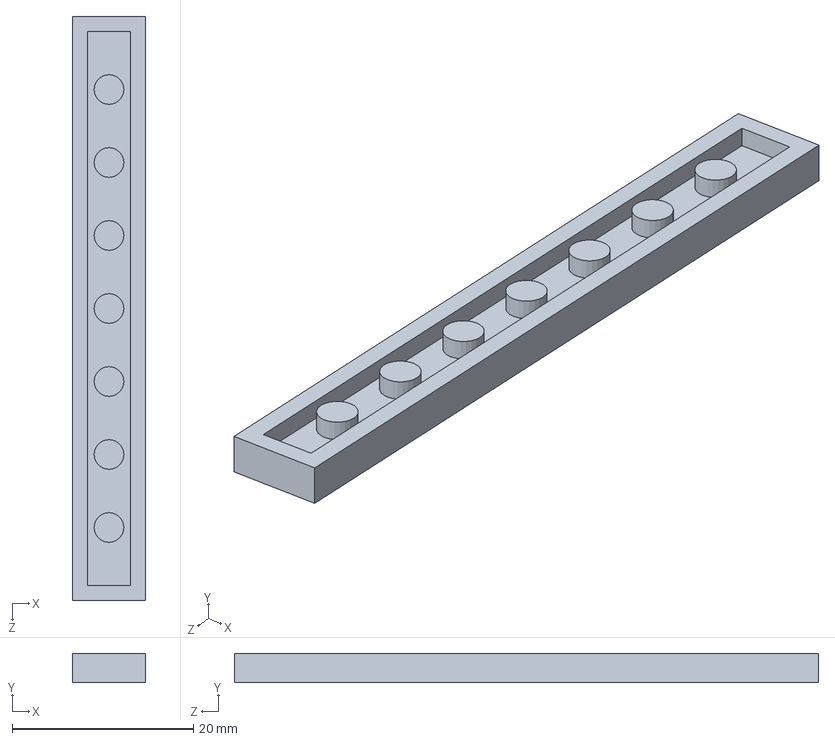
[picture p105: CAD file, 2018-03-05]
Dissertation/Resources/SolidWorks/SldParts/4162.SLDPRT
8.07 x 3.23 x 64.5 mm
