worgarside/CubeSolver/Dissertation/Resources/SolidWorks/SldParts/3743.SLDPRT

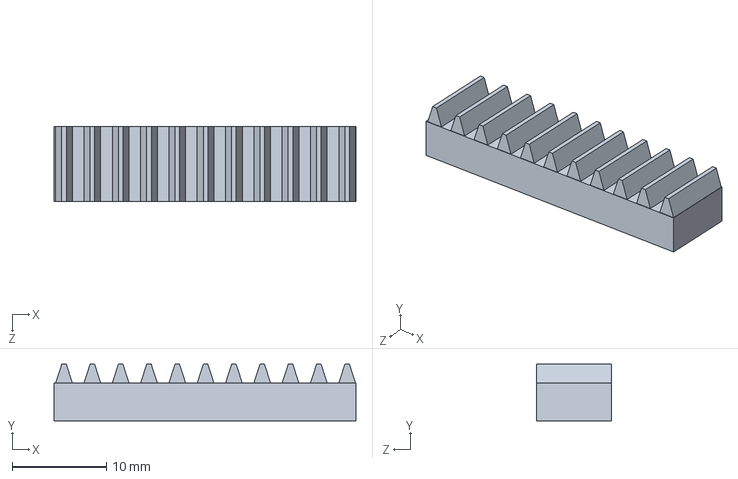
[picture p106: CAD file, 2018-03-05]
Dissertation/Resources/SolidWorks/SldParts/3743.SLDPRT
32.0 x 6.00 x 8.00 mm
