worgarside/CubeSolver/Dissertation/Resources/SolidWorks/SldParts/6632.SLDPRT

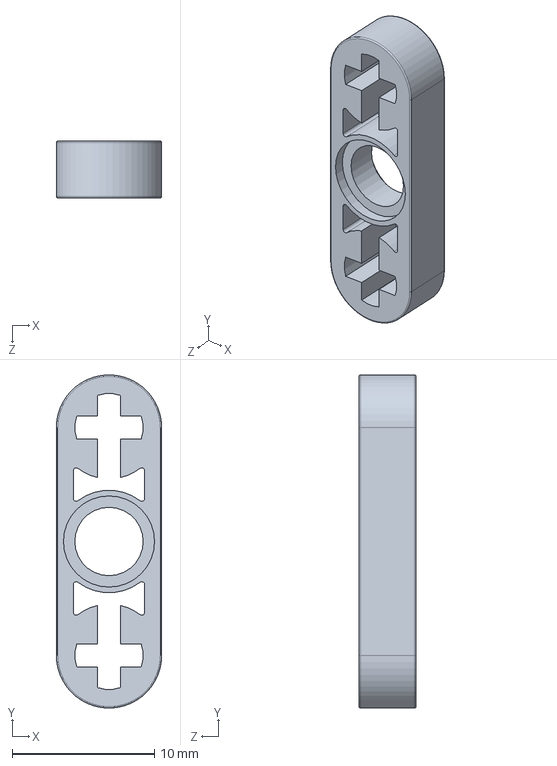
[picture p107: CAD file, 2018-03-05]
Dissertation/Resources/SolidWorks/SldParts/6632.SLDPRT
7.40 x 23.4 x 4.00 mm
