worgarside/CubeSolver/Dissertation/Resources/SolidWorks/SldParts/4274.SLDPRT

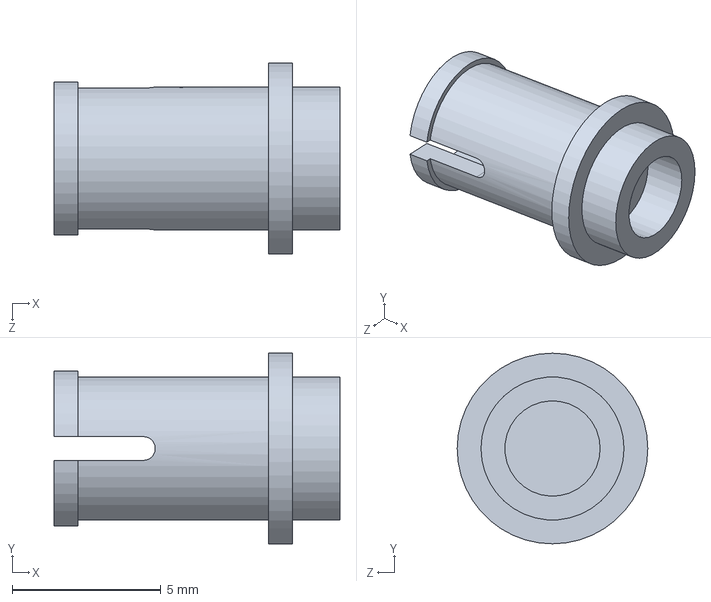
[picture p108: CAD file, 2018-03-05]
Dissertation/Resources/SolidWorks/SldParts/4274.SLDPRT
9.60 x 6.40 x 6.40 mm
