worgarside/CubeSolver/Dissertation/Resources/SolidWorks/SldParts/2780.SLDPRT

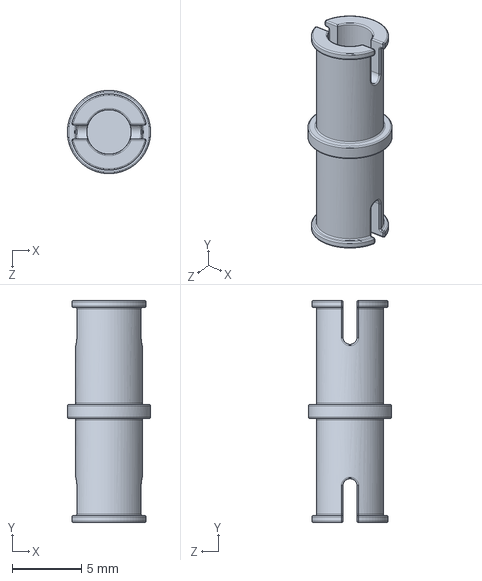
[picture p109: CAD file, 2018-03-05]
Dissertation/Resources/SolidWorks/SldParts/2780.SLDPRT
6.00 x 16.0 x 6.00 mm
