worgarside/CubeSolver/Dissertation/Resources/SolidWorks/SldParts/6538a.SLDPRT

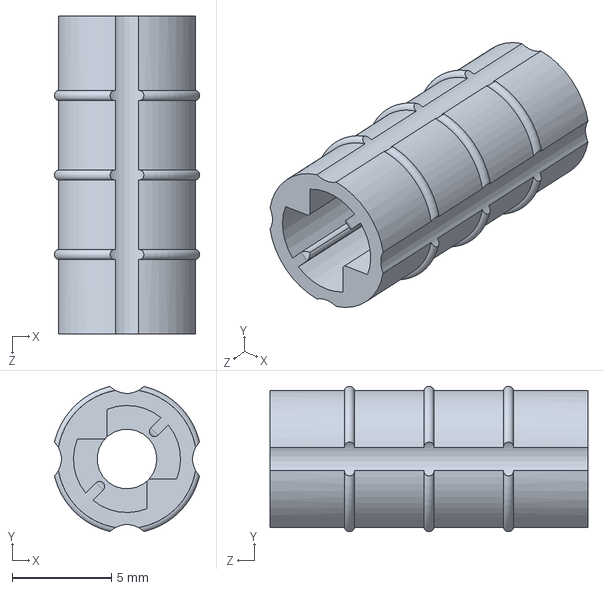
[picture p110: CAD file, 2018-03-03]
Dissertation/Resources/SolidWorks/SldParts/6538a.SLDPRT
7.30 x 7.30 x 16.0 mm
