worgarside/CubeSolver/Dissertation/Resources/SolidWorks/SldParts/Worm Gear.SLDPRT

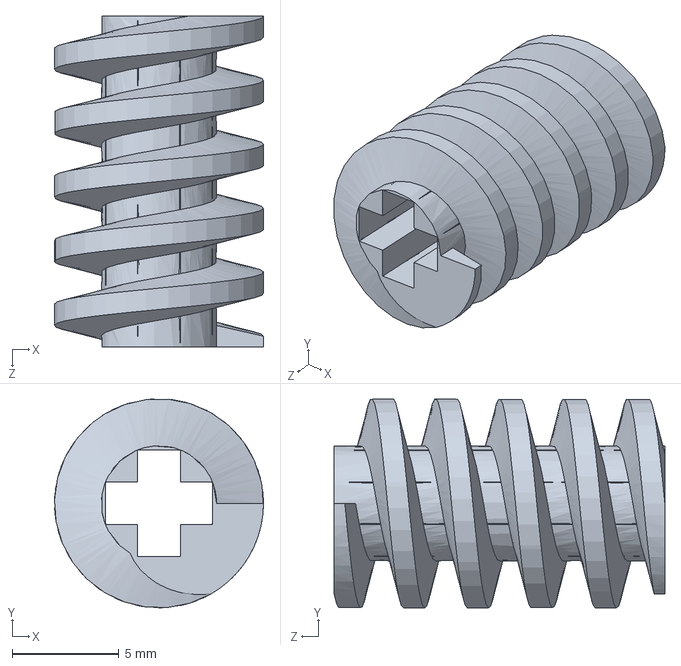
[picture p111: CAD file, 2018-03-01]
Dissertation/Resources/SolidWorks/SldParts/Worm Gear.SLDPRT
9.80 x 9.78 x 15.5 mm
