worgarside/CubeSolver/Dissertation/Resources/SolidWorks/SldParts/Cradle Part 2.SLDPRT

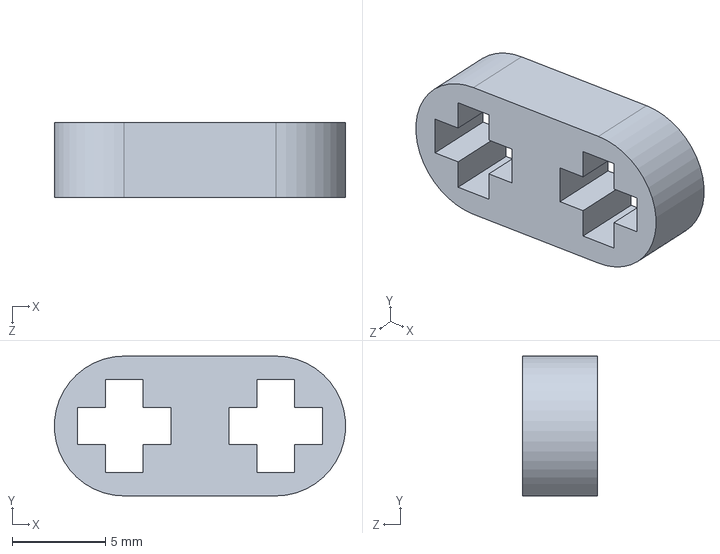
[picture p112: CAD file, 2018-03-01]
Dissertation/Resources/SolidWorks/SldParts/Cradle Part 2.SLDPRT
15.6 x 7.50 x 4.00 mm
