worgarside/CubeSolver/Dissertation/Resources/SolidWorks/SldParts/CubeProfile.SLDPRT

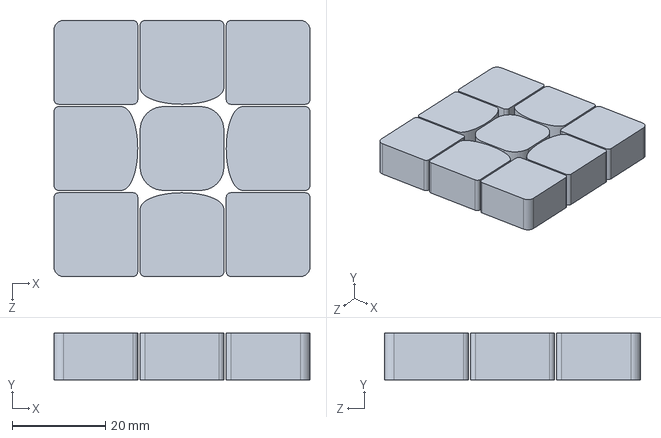
[picture p113: CAD file, 2018-02-28]
Dissertation/Resources/SolidWorks/SldParts/CubeProfile.SLDPRT
55.0 x 10.0 x 55.0 mm
