worgarside/CubeSolver/Dissertation/Resources/SolidWorks/SldParts/Cradle Part 1.SLDPRT

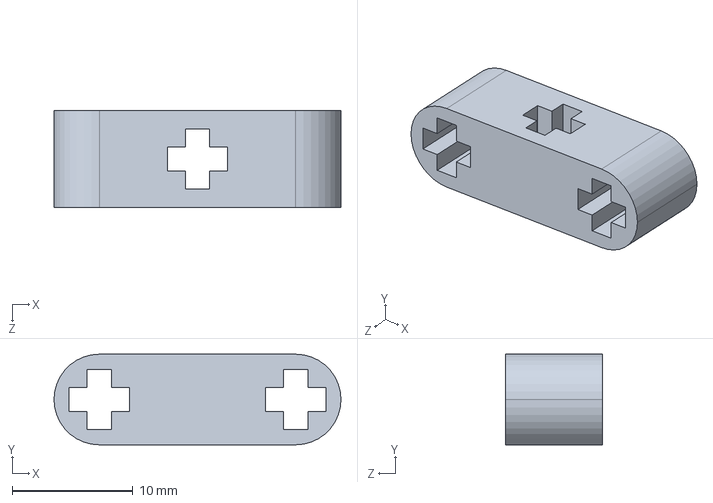
[picture p114: CAD file, 2018-02-28]
Dissertation/Resources/SolidWorks/SldParts/Cradle Part 1.SLDPRT
23.8 x 7.50 x 8.00 mm
