worgarside/CubeSolver/Dissertation/Resources/SolidWorks/SldParts/Axle.SLDPRT

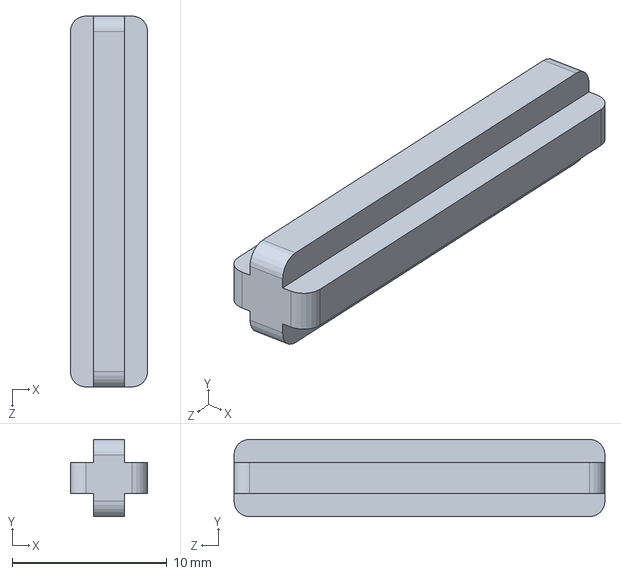
[picture p115: CAD file, 2018-02-28]
Dissertation/Resources/SolidWorks/SldParts/Axle.SLDPRT
5.00 x 5.00 x 24.0 mm
