worgarside/CubeSolver/Dissertation/Resources/SolidWorks/SldParts/Beam.SLDPRT

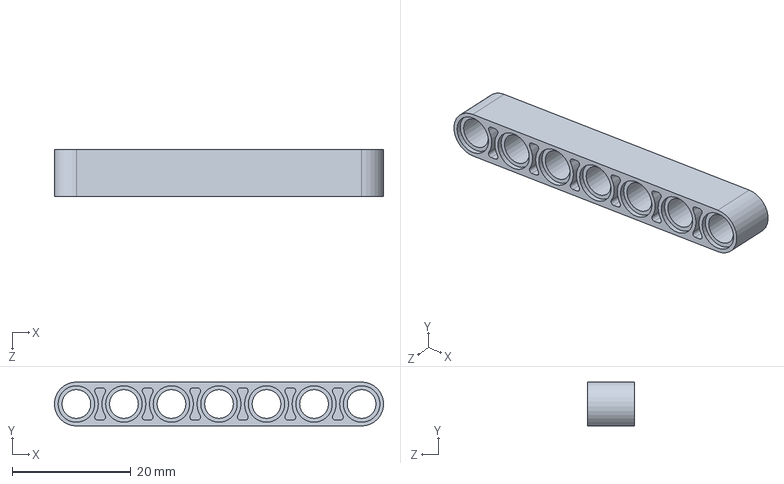
[picture p116: CAD file, 2018-02-28]
Dissertation/Resources/SolidWorks/SldParts/Beam.SLDPRT
55.4 x 7.40 x 7.85 mm
