worgarside/CubeSolver/Dissertation/Resources/SolidWorks/SldParts/Gear.SLDPRT

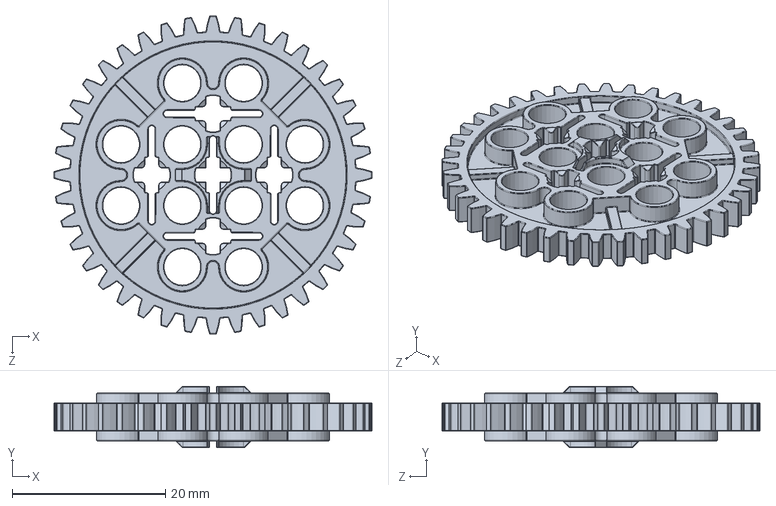
[picture p117: CAD file, 2018-02-28]
Dissertation/Resources/SolidWorks/SldParts/Gear.SLDPRT
41.5 x 8.00 x 41.5 mm
