worgarside/CubeSolver/(list of files, cad)

Other CAD files:
Dissertation/Resources/SolidWorks/Assemblies/10825-LtBluishGray.sldprt
Dissertation/Resources/SolidWorks/Assemblies/54732b-LtBluishGray.sldprt
Dissertation/Resources/SolidWorks/Assemblies/99550-LtBluishGray.sldprt
Dissertation/Resources/SolidWorks/Assemblies/99551-LtBluishGray.sldprt
Dissertation/Resources/SolidWorks/Assemblies/99555-White.sldprt
Dissertation/Resources/SolidWorks/Assemblies/99617-Red.sldprt
Dissertation/Resources/SolidWorks/Assemblies/CradleProfile old.SLDASM
Dissertation/Resources/SolidWorks/Assemblies/CradleProfile.SLDASM
Dissertation/Resources/SolidWorks/Drawings/10825-LtBluishGray.sldprt
Dissertation/Resources/SolidWorks/Drawings/54732b-LtBluishGray.sldprt
Dissertation/Resources/SolidWorks/Drawings/99550-LtBluishGray.sldprt
Dissertation/Resources/SolidWorks/Drawings/99551-LtBluishGray.sldprt
Dissertation/Resources/SolidWorks/Drawings/99555-White.sldprt
Dissertation/Resources/SolidWorks/Drawings/99617-Red.sldprt
Dissertation/Resources/SolidWorks/Drawings/Color Sensor.SLDDRW
Dissertation/Resources/SolidWorks/Drawings/CradleProfileV1.SLDDRW
Dissertation/Resources/SolidWorks/Drawings/Cube Profile with Cradle.SLDDRW
Dissertation/Resources/SolidWorks/Drawings/Curved Edge Normal.SLDDRW
Dissertation/Resources/SolidWorks/Drawings/Curved Edge Tilted.SLDDRW
Dissertation/Resources/SolidWorks/Drawings/Straight Edge Normal.SLDDRW
Dissertation/Resources/SolidWorks/Drawings/Swing Arm MkI.SLDDRW
Dissertation/Resources/SolidWorks/Drawings/Swing Arm V1.SLDDRW
Dissertation/Resources/SolidWorks/Drawings/Worm Gear.SLDDRW
Dissertation/Resources/SolidWorks/SldParts/10825-LtBluishGray.sldprt
Dissertation/Resources/SolidWorks/SldParts/11013-TransClear.sldprt
Dissertation/Resources/SolidWorks/SldParts/11014p01-Black.sldprt
Dissertation/Resources/SolidWorks/SldParts/32014.SLDPRT
Dissertation/Resources/SolidWorks/SldParts/32277.SLDPRT
Dissertation/Resources/SolidWorks/SldParts/32278.SLDPRT
Dissertation/Resources/SolidWorks/SldParts/32316.SLDPRT
Dissertation/Resources/SolidWorks/SldParts/32498.SLDPRT
Dissertation/Resources/SolidWorks/SldParts/32523.SLDPRT
Dissertation/Resources/SolidWorks/SldParts/32524.SLDPRT
Dissertation/Resources/SolidWorks/SldParts/32526.SLDPRT
Dissertation/Resources/SolidWorks/SldParts/40490.SLDPRT
Dissertation/Resources/SolidWorks/SldParts/42003.SLDPRT
Dissertation/Resources/SolidWorks/SldParts/43093.SLDPRT
Dissertation/Resources/SolidWorks/SldParts/44309.SLDPRT
Dissertation/Resources/SolidWorks/SldParts/54732b-LtBluishGray.sldprt
Dissertation/Resources/SolidWorks/SldParts/56145.SLDPRT
Dissertation/Resources/SolidWorks/SldParts/95650.SLDPRT
Dissertation/Resources/SolidWorks/SldParts/95650.sldasm
Dissertation/Resources/SolidWorks/SldParts/95658.SLDASM
Dissertation/Resources/SolidWorks/SldParts/99376-White.sldprt
Dissertation/Resources/SolidWorks/SldParts/99377-LtBluishGray.sldprt
Dissertation/Resources/SolidWorks/SldParts/99388-LtBluishGray.sldprt
Dissertation/Resources/SolidWorks/SldParts/99396-TransClear.sldprt
Dissertation/Resources/SolidWorks/SldParts/99550-LtBluishGray.sldprt
Dissertation/Resources/SolidWorks/SldParts/99550c01.sldasm
Dissertation/Resources/SolidWorks/SldParts/99551-LtBluishGray.sldprt
Dissertation/Resources/SolidWorks/SldParts/99555-White.sldprt
Dissertation/Resources/SolidWorks/SldParts/99617-Red.sldprt
