worgarside/CubeSolver/(commit log)

2017-06-12 GUI Color changes implemented, buttons all functioning
2017-06-12 Fixed more bugs, added buttons to GUI
2017-06-14 Tidied prints, modifiying solving method
2017-06-15 Added action button and fixed bug with for loop in whiteCrossYellowFace
2017-06-17 Removed print statements
2017-06-18 Removed prints and added comments
2017-08-14 Fixed move bugs and added chaining/randomizing
    [cube_class.py, main.py]
2017-08-19 Added motor function and init_motors
2017-08-21 More work on fine-tuning colors and rebuilds to physical bot to increase accuracy. e.g. New platter w/ motor directly attached, new shaft for driving cs, and rear grip for cs slider
2017-08-23 Build (hopefully) complete! Top face (basic) implemented and printing
2017-08-24 Scanning single face works, no weird bugs in this version. Hold function implemented
    [cube_class.py, main.py]
2017-08-27 Added function framework for creating moves. Removed Java
2017-08-27 Added more to function framework
2017-08-27 Added basic moves, need to rebuild swing arm though
2017-09-02 Added robotified move testing, fixed bug with move_r function
    [cube_class.py, main.py]
2017-09-04 MAJOR REWRITE. Separated all classes, split moves into 3 main layers - will add comments asap. Lots and lots of optimisation and tidying of code. Current state makes fish move sequence (hard coded)
2017-09-09 Small changes, started solving - trying to find bug with ['e2', 's2'] sequence
    [cube_class.py, main.py, robot_class.py, tertiary_moves.py]
2017-09-11 Re-written normalization, fixed bug with incorrect dictionary entries
    [cube_class.py, main.py]
2017-09-11 Added sleep in grab_cube to stop cube sliding action instead of flipping
    [robot_class.py]
2018-02-05 All current work in LaTex
2018-02-05 Better cube w/ colored prints
2018-02-05 Working on linked list and position generation
    [2018-02-05 2055.csv]
2018-02-06 Testing linked list functionality
    [2018-02-05 2055.csv]
2018-02-07 Added Exponential Growth spreadsheet, and research files from Dropbox
    [Data.xlsx, Exponential Growth.xlsx]
2018-02-07 Correct position generation (path tracing possible) - no optimisation
    [2018-02-07 1145.csv, 2018-02-07 1146.csv, 2018-02-07 1147.csv, 2018-02-07 1150.csv, 2018-02-07 1152.csv, 2018-02-07 1155.csv]
2018-02-07 Removed csv files
    [2018-02-07 1145.csv, 2018-02-07 1146.csv, 2018-02-07 1147.csv, 2018-02-07 1150.csv, 2018-02-07 1152.csv, 2018-02-07 1155.csv]
2018-02-07 Duplication & leaf checking
    [2018-02-07 1158.csv, 2018-02-07 1159.csv, 2018-02-07 1202.csv, 2018-02-07 1217.csv, 2018-02-07 1219.csv, 2018-02-07 1320.csv, 2018-02-07 1321.csv, 2018-02-07 1325.csv]
2018-02-07 Testing, updated gitignore
    [2018-02-07 1158.csv, 2018-02-07 1159.csv, 2018-02-07 1202.csv, 2018-02-07 1217.csv, 2018-02-07 1320.csv, 2018-02-07 1321.csv, 2018-02-07 1325.csv, 2018-02-07 1326.csv]
2018-02-07 Added position coding to eliminate XYZ moves
    [2018-02-07 1219.csv, 2018-02-07 1328.csv, 2018-02-07 1624.csv, 2018-02-07 1727.csv, 2018-02-07 1728.csv, 2018-02-07 1729.csv, 2018-02-07 1732.csv, 2018-02-07 1736.csv]
2018-02-07 update gitignore
    [2018-02-07 1624.csv, 2018-02-07 1727.csv, 2018-02-07 1728.csv, 2018-02-07 1729.csv, 2018-02-07 1732.csv, 2018-02-07 1736.csv]
2018-02-07 Database addition implemented, seems to be a LOT slower than generator -> set -> db
    [Exponential Growth.xlsx]
2018-02-08 Reverted to generator -> set -> db
    [main.py]
2018-02-08 Starting work on Korf pending meeting with SDN, currently non-functional
2018-02-09 Backtrace complete but returning wrong order
    [main.py]
2018-02-09 Cube solved! Seems quite slow though, needs optimising
    [main.py]
2018-02-09 Working on printout and move chaining
2018-02-09 Fixed non-printing bug
2018-02-09 Backtracing removed in favour of move chaining, printout modified
2018-02-09 Updated printout, much nicer
2018-02-09 Nicer printout
2018-02-09 Colored printout
2018-02-11 Thread/Queue test functioning
2018-02-11 Queue is functioning, threads don't appear to be concurrent
2018-02-12 Better scaling, added safer termination control and changed timer location
2018-02-13 LIFOQueue implemented, bug fixes and timer added
    [main.py]
2018-02-14 Changed folder structure for socket with EV3
2018-02-14 More EV3 setup
    [voltage.xlsx]
2018-02-15 Created basic socket server-client files
2018-02-15 Robot functioning and adjusted for new gearing
2018-02-18 Fixed bug from new color enum
    [robot_class.py]
2018-02-19 Fixed type error bug with new color
    [main.py, robot_class.py]
2018-02-19 Fixed Good/Bad detection bug with not checking both facelets on cubie
    [main.py]
2018-02-19 Bug fix: no longer checks up/down faces for goodness
    [cube_class.py, main.py]
2018-02-20 Sequences correctly transmitted to robot and correctly performed. Old code has been used and will need looking over to improve it.
    [cube_class.py, main.py, primary_moves.py, robot_class.py, secondary_moves.py]
2018-02-21 Added average timer to robot and bug fixes
    [scan_times.csv]
2018-02-21 Created separate function for move processing in GOOD/BAD in preparation for pooling
    [scan_times.csv]
2018-02-22 Speed increases
    [scan_times.csv]
2018-02-22 Second phase complete, corners are now moved to good positions
    [scan_times.csv]
2018-02-23 Thistlethwaite-esque method all but complete, need to change DB structure to hold serialized lists and not strings though
    [Exponential Growth.xlsx]
2018-02-23 Thistlethwaite method implemented successfully
    [Exponential Growth.xlsx]
2018-02-25 Addition to previous commit, some files blocked
    [Exponential Growth.xlsx, scan_times.csv]
2018-02-25 Added phase one monochrome conversion, initial tests show great optimisation with same output
    [Exponential Growth.xlsx]
2018-02-26 Phase 4 and 5 generation in progress, seems to overflow depth 18 though
    [Exponential Growth.xlsx]
2018-02-28 Work on design chapter of doc
    [CradleProfile.SLDDRW, CubeProfile.SLDDRW]
2018-02-28 Work on CAD for drawings
    [Axle.SLDPRT, Beam.SLDPRT, CradleProfile.SLDASM, CradleProfile.SLDDRW, CubePart2.SLDPRT, CubeProfile.SLDDRW, CubeProfile.SLDPRT, Drawing.SLDDRW]
2018-03-01 CAD work and diss doc algorithms etc.
    [Axle.SLDPRT, Beam.SLDPRT, CradleProfile Straight Edged.SLDASM, CradleProfile Worm Gear.SLDASM, CradleProfile old.SLDASM, CradleProfile.SLDASM, CradleProfile.SLDDRW, CubePart2.SLDPRT]
2018-03-01 Added parts
    [Axle.SLDPRT, Beam.SLDPRT, Bush.SLDPRT, Cradle Part 1.SLDPRT, Cradle Part 2.SLDPRT, CubeProfile.SLDPRT, Gear.SLDPRT, Worm Gear.SLDPRT]
2018-03-03 Starting to optimize table 4 generation
    [40490.SLDPRT, 42003.SLDPRT, 44309.SLDPRT, 56145.SLDPRT, 6538a.SLDPRT, Swing Arm MkI.SLDASM, Wheel.SLDASM]
2018-03-04 More refactoring and optimisation
    [Memory Logging.xlsx]
2018-03-05 CAD work, drawings and LEGO models & MemLogs
    [2780.SLDPRT, 32014.SLDPRT, 32277.SLDPRT, 32278.SLDPRT, 32316.SLDPRT, 32523.SLDPRT, 32524.SLDPRT, CradleProfile Worm Gear.SLDASM]
2018-03-05 CAD work and drawings. Added color sensor drawing to doc
    [11013-TransClear.sldprt, 11014p01-Black.sldprt, 32277.SLDPRT, 32526.SLDPRT, 3708.SLDPRT, 3743.SLDPRT, 4162.SLDPRT, 4274.SLDPRT]
2018-03-06 More mp testing, looking at mp with queue to alleviate memory usage ASAP
    [Memory Logging.xlsx]
2018-03-06 Attempting to get DB write and data generation in concurrent process, but this requires a db.commit() after every insert to avoid building up memory usage - and therefore slows the process down soooo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
2018-03-08 Small changes ready for long gen session
    [Memory Logging.xlsx]
2018-03-15 Fixed table gen OutOfRange bug, refactored move translation
    [main.py, primary_moves.py, secondary_moves.py, tertiary_moves.py]
2018-03-28 Bit more work on design stage
2018-03-28 Added more renders and completed (?) 3D model part of design stage
2018-03-30 Part-way through restructuring document, also added better flow and more content
    [CradleProfile.SLDASM, Cube Profile with Cradle.SLDDRW]
2018-04-01 Updated some drawings/CAD and restructuring
    [10825-LtBluishGray.sldprt, 32498.SLDPRT, 54732b-LtBluishGray.sldprt, 95658.SLDASM, 99550-LtBluishGray.sldprt, 99550c01.sldasm, 99551-LtBluishGray.sldprt, 99555-White.sldprt]
2018-04-07 Continued work on design stage
2018-04-11 Huge codebase update, all methods functioning now
    [voltage.xlsx]
2018-04-11 Codebase complete. Needs testing with robot and commenting
    [scan_times.csv]
2018-04-11 More comments, show_off method, robot refinements from today's refactoring
    [scan_times.csv]
2018-04-18 Small changes, recording tree generation times
    [Tree Generator.xlsx]
2018-04-19 Added tree solving data
    [Tree Generator.xlsx]
2018-04-19 Tree Solve codebase work
    [Tree Generator.xlsx]
2018-04-19 Small updates to code and more work to tex
    [Tree Generator.xlsx]
2018-04-20 Removed prints
2018-04-23 Removed table gen modification from Code, starting work on results and discussion
    [Cradle Rotations.csv, Memory Logging.xlsx, Memory Logs.csv]
2018-04-24 Updated prints
2018-04-24 First draft of results and discussion complete
    [Memory Logs.csv]
2018-04-24 Memory logging from full run through
    [Memory Logging.xlsx, Tree Generator.xlsx, WILLS-DESKTOP_DataCollector01.csv, WILLS-DESKTOP_DataCollector01.xlsx, WILLS-DESKTOP_DataCollector012.xlsx]
2018-04-25 Finished conclusion
    [Memory Logging.xlsx]
2018-05-08 Poster session prep, surface -> desktop
    [scan_times.csv]
2018-05-08 MotorStall handler in place
